ataffanel/fp65/mpu-a/readme.md

# wdc65C02s CPU board with clock

CPU board for the 65C02.

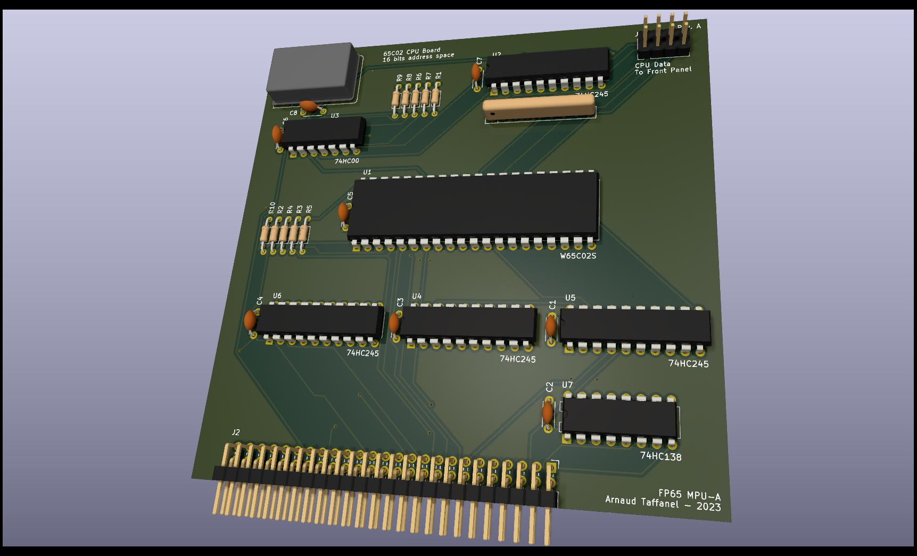
[picture p2: mpu-a/doc/mpu-a.jpg]
Render of the cpu board


Implements support for a crystall oscillator and connector and logic for a front-pannel to access the CPU data line even when isolated from the backplane.

Also generates an enable signal for selecting the IO pages at ```$Cxxx```.
