ataffanel/fp65/(list of files, drawings)

Other design files:
ram-a/freerouting.dsn
