ataffanel/fp65/sio-a/sio-a.kicad_pcb

## KiCad design sio-a/sio-a.kicad_pcb (2023-12-28)

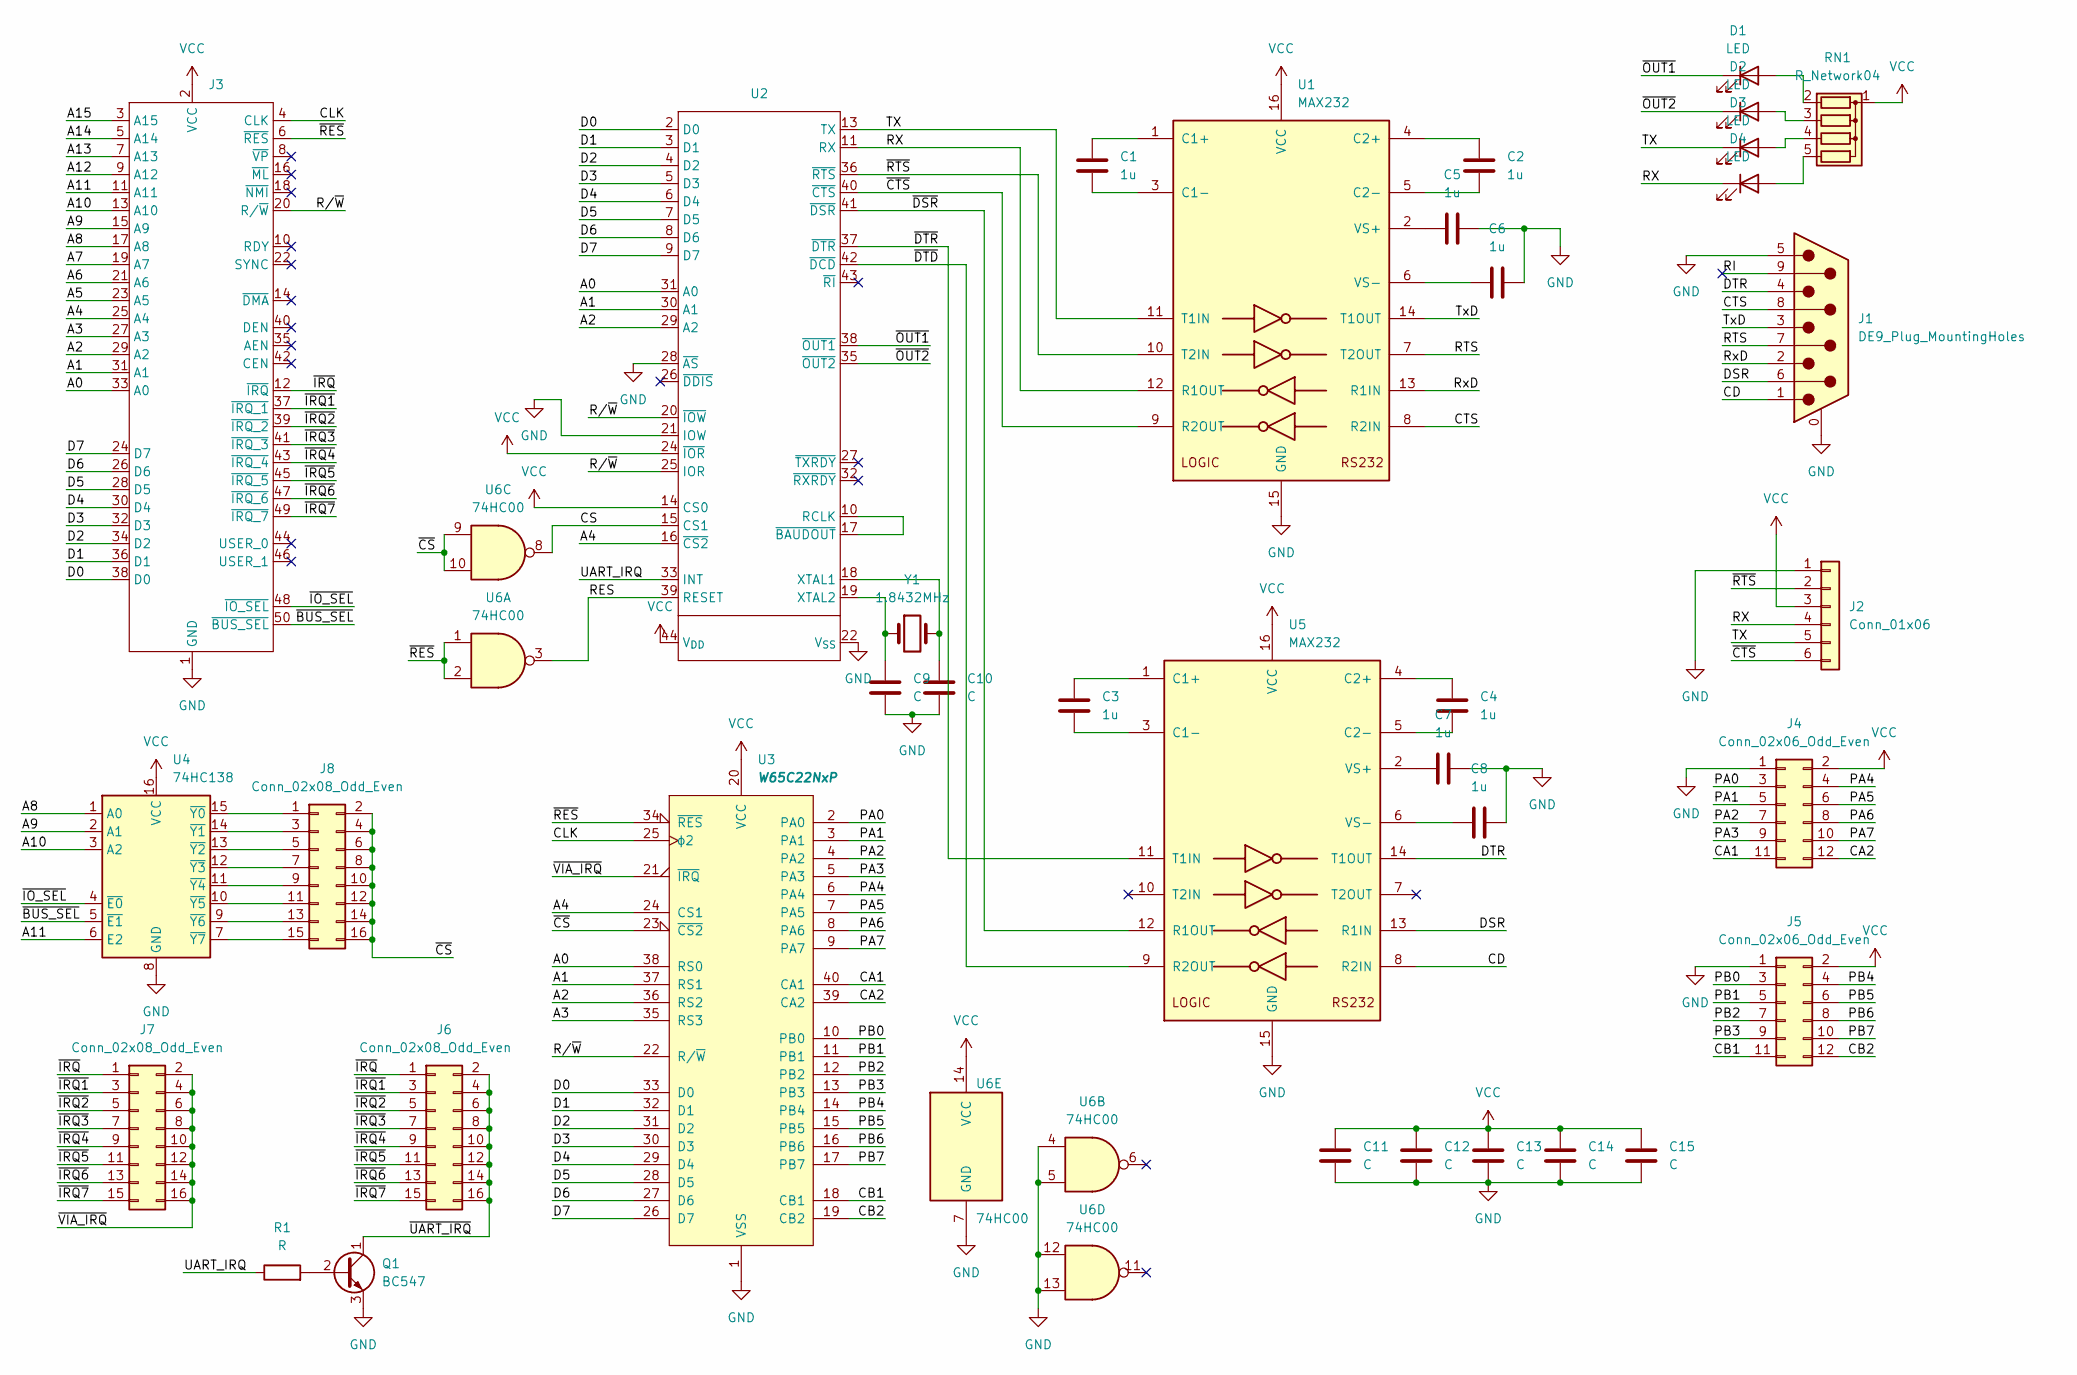
[picture p3: schematic sio-a.kicad_sch]

Parts:
C1, C2, C3, C4, C5, C6, C7, C8: 1u; C_Disc_D5.0mm_W2.5mm_P5.00mm
C9, C10, C11, C12, C13, C14, C15: C; C_Disc_D5.0mm_W2.5mm_P5.00mm
D1, D2, D3, D4: LED; LED_D3.0mm_Horizontal_O1.27mm_Z2.0mm
J1: DE9_Plug_MountingHoles; DSUB-9_Male_Horizontal_P2.77x2.84mm_EdgePinOffset9.90mm_Hou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
J2: Conn_01x06; PinHeader_1x06_P2.54mm_Horizontal
J3: PinHeader_2x25_P2.54mm_Horizontal
J4, J5: Conn_02x06_Odd_Even; PinHeader_2x06_P2.54mm_Vertical
J6, J7, J8: Conn_02x08_Odd_Even; PinHeader_2x08_P2.54mm_Vertical
Q1: BC547; TO-92_Inline
R1: R; R_Axial_DIN0207_L6.3mm_D2.5mm_P10.16mm_Horizontal
RN1: R_Network04; R_Array_SIP5
U1, U5: MAX232; DIP-16_W7.62mm
U2: PLCC-44_THT-Socket
U3: W65C22NxP; DIP-40_W15.24mm
U4: 74HC138; DIP-16_W7.62mm
U6: 74HC00; DIP-14_W7.62mm
Y1: 1.8432MHz; Crystal_HC49-U_Vertical

Connections:
/A0: J3.33 (A0), U2.31 (A0), U3.38 (RS0)
/A1: J3.31 (A1), U2.30 (A1), U3.37 (RS1)
/A2: J3.29 (A2), U2.29 (A2), U3.36 (RS2)
/A3: J3.27 (A3), U3.35 (RS3)
/A4: J3.25 (A4), U2.16 (~CS2), U3.24 (CS1)
/A5: J3.23 (A5)
/A6: J3.21 (A6)
/A7: J3.19 (A7)
/A8: J3.17 (A8), U4.1 (A0)
/A9: J3.15 (A9), U4.2 (A1)
/A10: J3.13 (A10), U4.3 (A2)
/A11: J3.11 (A11), U4.6 (E2)
/A12: J3.9 (A12)
/A13: J3.7 (A13)
/A14: J3.5 (A14)
/A15: J3.3 (A15)
/CA1: J4.11, U3.40 (CA1)
/CA2: J4.12, U3.39 (CA2)
/CB1: J5.11, U3.18 (CB1)
/CB2: J5.12, U3.19 (CB2)
/CD: J1.1, U5.8 (R2IN)
/CLK: J3.4 (CLK), U3.25 (ϕ2)
/CS: U2.15 (CS1), U6.8
/CTS: J1.8, U1.8 (R2IN)
/D0: J3.38 (D0), U2.2 (D0), U3.33 (D0)
/D1: J3.36 (D1), U2.3 (D1), U3.32 (D1)
/D2: J3.34 (D2), U2.4 (D2), U3.31 (D2)
/D3: J3.32 (D3), U2.5 (D3), U3.30 (D3)
/D4: J3.30 (D4), U2.6 (D4), U3.29 (D4)
/D5: J3.28 (D5), U2.7 (D5), U3.28 (D5)
/D6: J3.26 (D6), U2.8 (D6), U3.27 (D6)
/D7: J3.24 (D7), U2.9 (D7), U3.26 (D7)
/DSR: J1.6, U5.13 (R1IN)
/DTR: J1.4, U5.14 (T1OUT)
/PA0: J4.3, U3.2 (PA0)
/PA1: J4.5, U3.3 (PA1)
/PA2: J4.7, U3.4 (PA2)
/PA3: J4.9, U3.5 (PA3)
/PA4: J4.4, U3.6 (PA4)
/PA5: J4.6, U3.7 (PA5)
/PA6: J4.8, U3.8 (PA6)
/PA7: J4.10, U3.9 (PA7)
/PB0: J5.3, U3.10 (PB0)
/PB1: J5.5, U3.11 (PB1)
/PB2: J5.7, U3.12 (PB2)
/PB3: J5.9, U3.13 (PB3)
/PB4: J5.4, U3.14 (PB4)
/PB5: J5.6, U3.15 (PB5)
/PB6: J5.8, U3.16 (PB6)
/PB7: J5.10, U3.17 (PB7)
/RES: U2.39 (RESET), U6.3
/RI: J1.9
/RTS: J1.7, U1.7 (T2OUT)
/RX: D4.1 (K), J2.4, U1.12 (R1OUT), U2.11 (RX)
/RxD: J1.2, U1.13 (R1IN)
/R/~W: J3.20 (R/~W), U2.20 (~IOW), U2.25 (IOR), U3.22 (R/~W)
/TX: D3.1 (K), J2.5, U1.11 (T1IN), U2.13 (TX)
/TxD: J1.3, U1.14 (T1OUT)
/UART_IRQ: R1.1, U2.33 (INT)
/~BUS_SEL: J3.50 (~BUS_SEL), U4.5 (~E1)
/~CS: J8.2, J8.4, J8.6, J8.8, J8.10, J8.12, J8.14, J8.16, U3.23 (~CS2), U6.9, U6.10
/~CTS: J2.6, U1.9 (R2OUT), U2.40 (~CTS)
/~DSR: U2.41 (~DSR), U5.12 (R1OUT)
/~DTD: U2.42 (~DCD), U5.9 (R2OUT)
/~DTR: U2.37 (~DTR), U5.11 (T1IN)
/~IO_SEL: J3.48 (~IO_SEL), U4.4 (~E0)
/~IRQ1: J3.37 (~IRQ_1), J6.3, J7.3
/~IRQ2: J3.39 (~IRQ_2), J6.5, J7.5
/~IRQ3: J3.41 (~IRQ_3), J6.7, J7.7
/~IRQ4: J3.43 (~IRQ_4), J6.9, J7.9
/~IRQ5: J3.45 (~IRQ_5), J6.11, J7.11
/~IRQ6: J3.47 (~IRQ_6), J6.13, J7.13
/~IRQ7: J3.49 (~IRQ_7), J6.15, J7.15
/~IRQ: J3.12 (~IRQ), J6.1, J7.1
/~OUT1: D1.1 (K), U2.38 (~OUT1)
/~OUT2: D2.1 (K), U2.35 (~OUT2)
/~RES: J3.6 (~RES), U3.34 (~RES), U6.1, U6.2
/~RTS: J2.2, U1.10 (T2IN), U2.36 (~RTS)
/~UART_IRQ: J6.2, J6.4, J6.6, J6.8, J6.10, J6.12, J6.14, J6.16, Q1.1 (C)
/~VIA_IRQ: J7.2, J7.4, J7.6, J7.8, J7.10, J7.12, J7.14, J7.16, U3.21 (~IRQ)
GND: C5.2, C6.2, C7.1, C8.2, C9.2, C10.2, C11.2, C12.2, C13.2, C14.2, C15.2, J1.0 (PAD), J1.5, J2.1, J3.1 (GND), J4.1, J5.1, Q1.3 (E), U1.15 (GND), U2.21 (IOW), U2.22 (V_{SS}), U2.28 (~AS), U3.1 (VSS), U4.8 (GND), U5.15 (GND), U6.4, U6.5, U6.7 (GND), U6.12, U6.13
unnamed: D1.2 (A), RN1.2 (R1)
unnamed: D2.2 (A), RN1.3 (R2)
unnamed: D3.2 (A), RN1.4 (R3)
unnamed: D4.2 (A), RN1.5 (R4)
unnamed: J8.1, U4.15 (~Y0)
unnamed: J8.3, U4.14 (~Y1)
unnamed: J8.5, U4.13 (~Y2)
unnamed: J8.7, U4.12 (~Y3)
unnamed: J8.9, U4.11 (~Y4)
unnamed: J8.11, U4.10 (~Y5)
unnamed: J8.13, U4.9 (~Y6)
unnamed: J8.15, U4.7 (~Y7)
unnamed: Q1.2 (B), R1.2
unnamed: C1.1, U1.1 (C1+)
unnamed: C1.2, U1.3 (C1-)
unnamed: C2.1, U1.4 (C2+)
unnamed: C2.2, U1.5 (C2-)
unnamed: C5.1, U1.2 (VS+)
unnamed: C6.1, U1.6 (VS-)
unnamed: U2.10 (RCLK), U2.17 (~BAUDOUT)
unnamed: C10.1, U2.18 (XTAL1), Y1.2
unnamed: C9.1, U2.19 (XTAL2), Y1.1
unnamed: C3.1, U5.1 (C1+)
unnamed: C3.2, U5.3 (C1-)
unnamed: C4.1, U5.4 (C2+)
unnamed: C4.2, U5.5 (C2-)
unnamed: C7.2, U5.2 (VS+)
unnamed: C8.1, U5.6 (VS-)
VCC: C11.1, C12.1, C13.1, C14.1, C15.1, J2.3, J3.2 (VCC), J4.2, J5.2, RN1.1 (common), U1.16 (VCC), U2.14 (CS0), U2.24 (~IOR), U2.44 (V_{DD}), U3.20 (VCC), U4.16 (VCC), U5.16 (VCC), U6.14 (VCC)

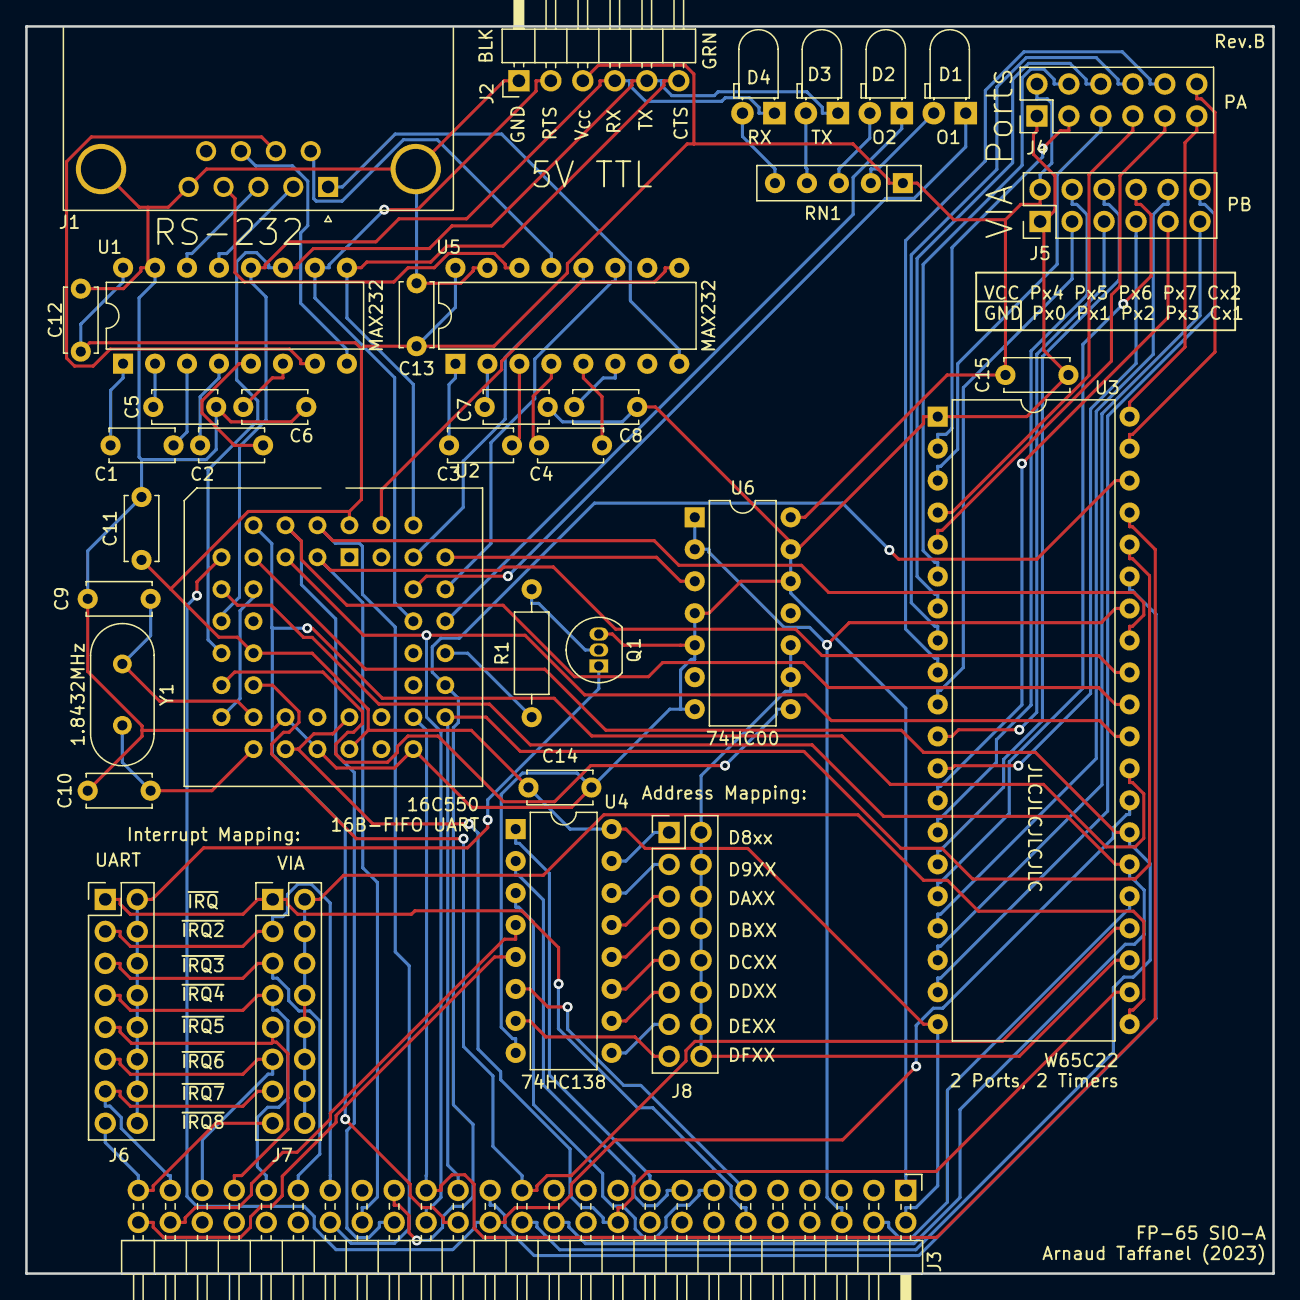
[picture p4: board sio-a.kicad_pcb from above]

Board: 2 copper layers, 99.1 x 99.1 mm, 37 parts (0 on the bottom side), 102 nets.
