ataffanel/fp65/scsi-a/scsi-a.kicad_pcb

## KiCad design scsi-a/scsi-a.kicad_pcb (2023-12-28)

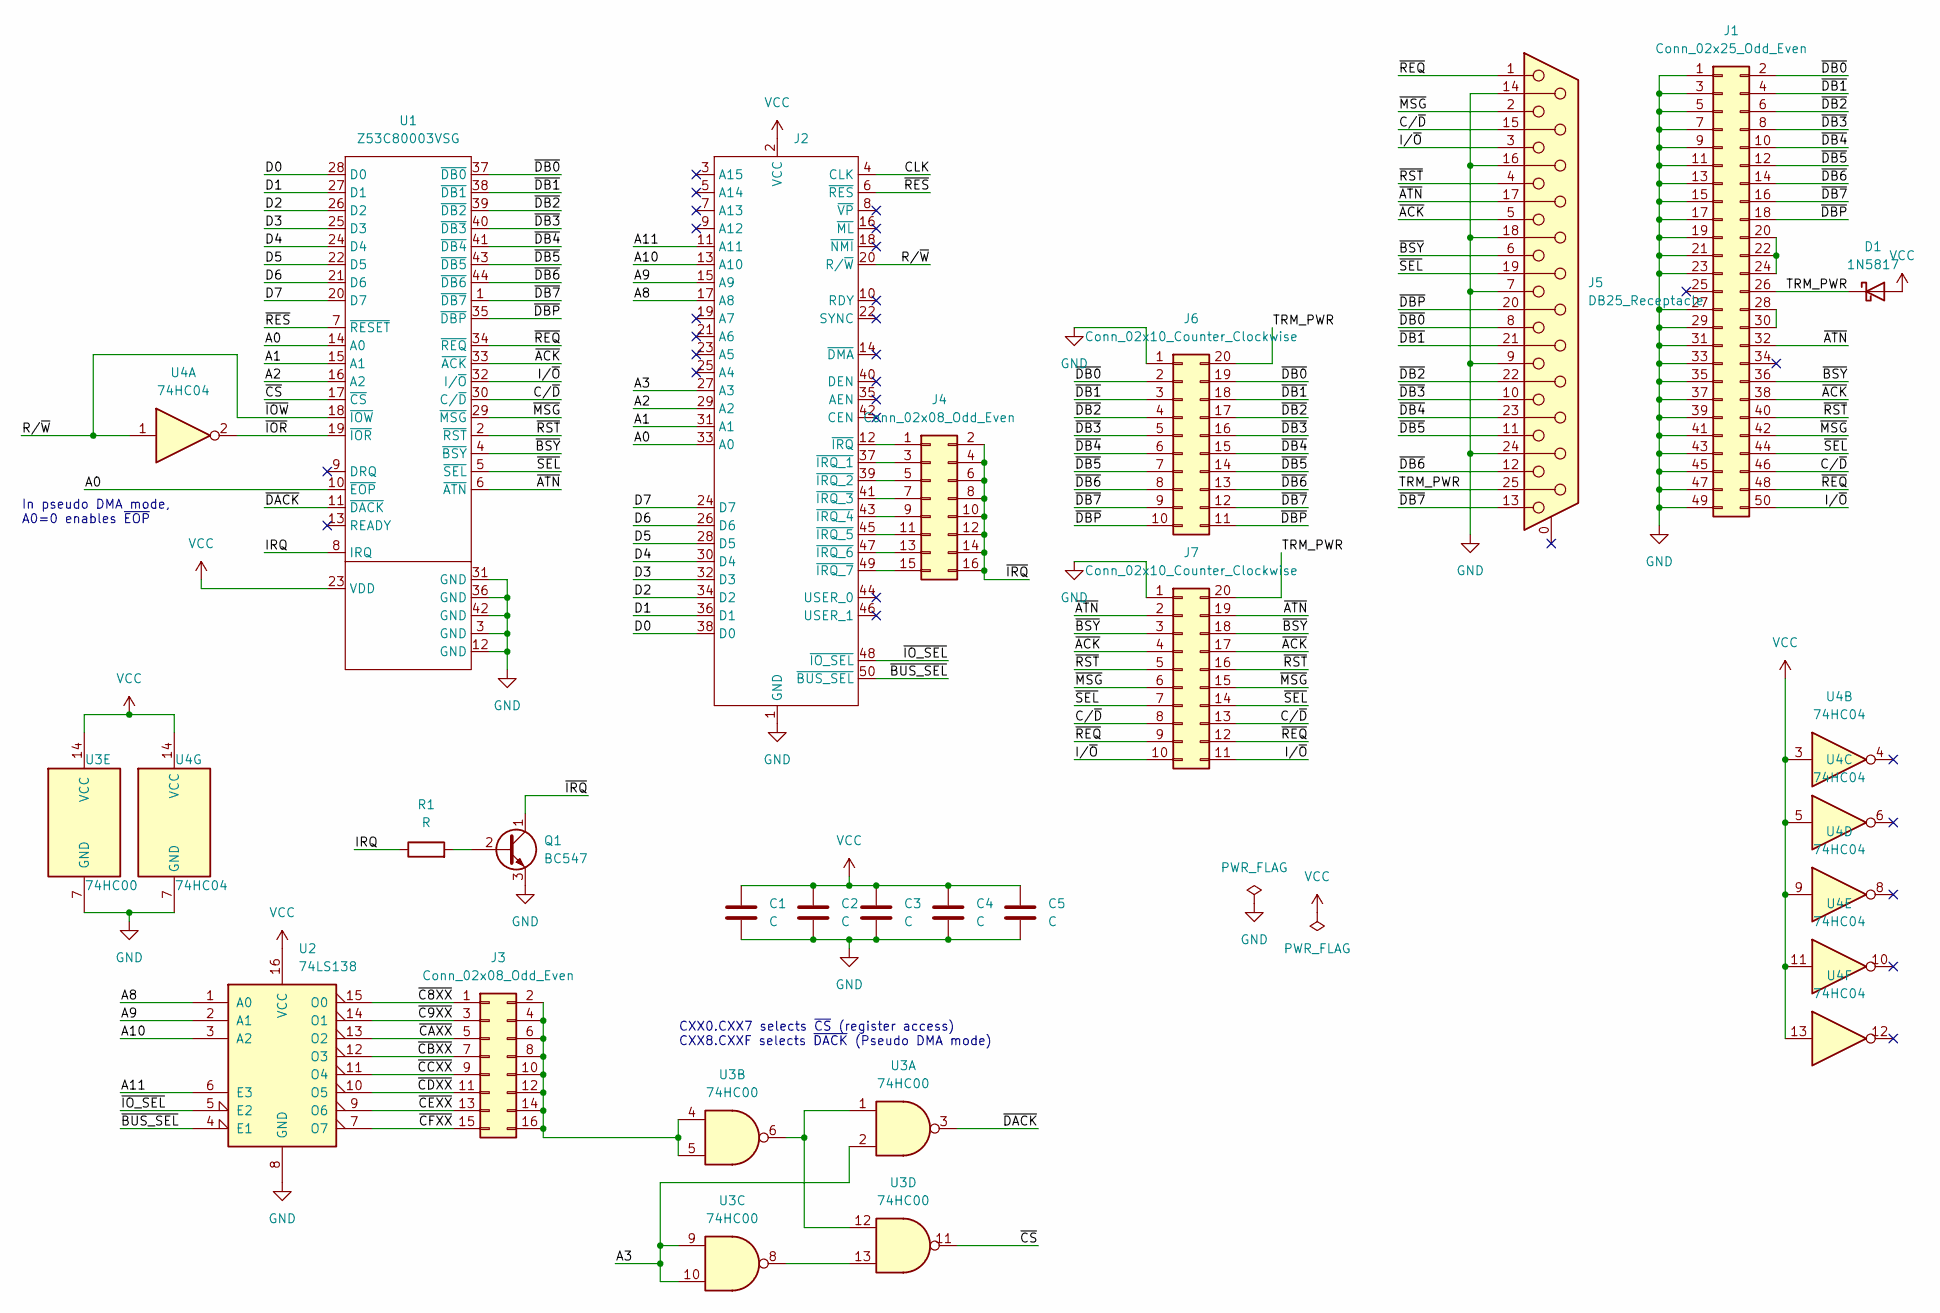
[picture p5: schematic scsi-a.kicad_sch, FP65 SCSI-SC interface]

Parts:
C1, C2, C3, C5: C; C_Disc_D5.0mm_W2.5mm_P5.00mm
C4: C; CP_Radial_D5.0mm_P2.00mm
D1: 1N5817; D_DO-41_SOD81_P10.16mm_Horizontal
J1: Conn_02x25_Odd_Even; IDC-Header_2x25_P2.54mm_Horizontal
J2: PinHeader_2x25_P2.54mm_Horizontal
J3, J4: Conn_02x08_Odd_Even; PinHeader_2x08_P2.54mm_Vertical
J5: DB25_Receptacle; DSUB-25_Female_Horizontal_P2.77x2.84mm_EdgePinOffset9.90mm_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
J6, J7: Conn_02x10_Counter_Clockwise; DIP-20_W7.62mm_Socket
Q1: BC547; TO-92_Inline
R1: R; R_Axial_DIN0204_L3.6mm_D1.6mm_P7.62mm_Horizontal
U1: Z53C80003VSG; PLCC-44_THT-Socket
U2: 74LS138; DIP-16_W7.62mm
U3: 74HC00; DIP-14_W7.62mm
U4: 74HC04; DIP-14_W7.62mm

Connections:
/A0: J2.33 (A0), U1.10 (~EOP), U1.14 (A0)
/A1: J2.31 (A1), U1.15 (A1)
/A2: J2.29 (A2), U1.16 (A2)
/A3: J2.27 (A3), U3.2, U3.9, U3.10
/A8: J2.17 (A8), U2.1 (A0)
/A9: J2.15 (A9), U2.2 (A1)
/A10: J2.13 (A10), U2.3 (A2)
/A11: J2.11 (A11), U2.6 (E3)
/CLK: J2.4 (CLK)
/C/~D: J1.46, J5.15, J7.8, J7.13, U1.30 (C/~D)
/D0: J2.38 (D0), U1.28 (D0)
/D1: J2.36 (D1), U1.27 (D1)
/D2: J2.34 (D2), U1.26 (D2)
/D3: J2.32 (D3), U1.25 (D3)
/D4: J2.30 (D4), U1.24 (D4)
/D5: J2.28 (D5), U1.22 (D5)
/D6: J2.26 (D6), U1.21 (D6)
/D7: J2.24 (D7), U1.20 (D7)
/IRQ: R1.1, U1.8 (IRQ)
/I/~O: J1.50, J5.3, J7.10, J7.11, U1.32 (I/~O)
/R/~W: J2.20 (R/~W), U1.18 (~IOW), U4.1
/TRM_PWR: D1.1 (K), J1.26, J5.25, J6.20, J7.20
/~ACK: J1.38, J5.5, J7.4, J7.17, U1.33 (~ACK)
/~ATN: J1.32, J5.17, J7.2, J7.19, U1.6 (~ATN)
/~BSY: J1.36, J5.6, J7.3, J7.18, U1.4 (~BSY)
/~BUS_SEL: J2.50 (~BUS_SEL), U2.4 (E1)
/~C8XX: J3.1, U2.15 (O0)
/~C9XX: J3.3, U2.14 (O1)
/~CAXX: J3.5, U2.13 (O2)
/~CBXX: J3.7, U2.12 (O3)
/~CCXX: J3.9, U2.11 (O4)
/~CDXX: J3.11, U2.10 (O5)
/~CEXX: J3.13, U2.9 (O6)
/~CFXX: J3.15, U2.7 (O7)
/~CS: U1.17 (~CS), U3.11
/~DACK: U1.11 (~DACK), U3.3
/~DB0: J1.2, J5.8, J6.2, J6.19, U1.37 (~DB0)
/~DB1: J1.4, J5.21, J6.3, J6.18, U1.38 (~DB1)
/~DB2: J1.6, J5.22, J6.4, J6.17, U1.39 (~DB2)
/~DB3: J1.8, J5.10, J6.5, J6.16, U1.40 (~DB3)
/~DB4: J1.10, J5.23, J6.6, J6.15, U1.41 (~DB4)
/~DB5: J1.12, J5.11, J6.7, J6.14, U1.43 (~DB5)
/~DB6: J1.14, J5.12, J6.8, J6.13, U1.44 (~DB6)
/~DB7: J1.16, J5.13, J6.9, J6.12, U1.1 (~DB7)
/~DBP: J1.18, J5.20, J6.10, J6.11, U1.35 (~DBP)
/~IOR: U1.19 (~IOR), U4.2
/~IO_SEL: J2.48 (~IO_SEL), U2.5 (E2)
/~IRQ: J4.2, J4.4, J4.6, J4.8, J4.10, J4.12, J4.14, J4.16, Q1.1 (C)
/~MSG: J1.42, J5.2, J7.6, J7.15, U1.29 (~MSG)
/~REQ: J1.48, J5.1, J7.9, J7.12, U1.34 (~REQ)
/~RES: J2.6 (~RES), U1.7 (~RESET)
/~RST: J1.40, J5.4, J7.5, J7.16, U1.2 (~RST)
/~SEL: J1.44, J5.19, J7.7, J7.14, U1.5 (~SEL)
GND: C1.2, C2.2, C3.2, C4.2, C5.2, J1.1, J1.3, J1.5, J1.7, J1.9, J1.11, J1.13, J1.15, J1.17, J1.19, J1.21, J1.23, J1.27, J1.29, J1.31, J1.33, J1.35, J1.37, J1.39, J1.41, J1.43, J1.45, J1.47, J1.49, J2.1 (GND), J5.7, J5.9, J5.14, J5.16, J5.18, J5.24, J6.1, J7.1, Q1.3 (E), U1.3 (GND), U1.12 (GND), U1.31 (GND), U1.36 (GND), U1.42 (GND), U2.8 (GND), U3.7 (GND), U4.7 (GND)
unnamed: J1.20, J1.22, J1.24
unnamed: J1.28, J1.30
unnamed: J2.37 (~IRQ_1), J4.3
unnamed: J2.39 (~IRQ_2), J4.5
unnamed: J2.41 (~IRQ_3), J4.7
unnamed: J2.43 (~IRQ_4), J4.9
unnamed: J2.45 (~IRQ_5), J4.11
unnamed: J2.47 (~IRQ_6), J4.13
unnamed: J2.49 (~IRQ_7), J4.15
unnamed: J2.12 (~IRQ), J4.1
unnamed: J3.2, J3.4, J3.6, J3.8, J3.10, J3.12, J3.14, J3.16, U3.4, U3.5
unnamed: Q1.2 (B), R1.2
unnamed: U3.1, U3.6, U3.12
unnamed: U3.8, U3.13
VCC: C1.1, C2.1, C3.1, C4.1, C5.1, D1.2 (A), J2.2 (VCC), U1.23 (VDD), U2.16 (VCC), U3.14 (VCC), U4.3, U4.5, U4.9, U4.11, U4.13, U4.14 (VCC)

Notes on the sheet:
CXX0.CXX7 selects ~{CS} (register access) CXX8.CXXF selects ~{DACK} (Pseudo DMA mode)
In pseudo DMA mode, A0=0 enables ~{EOP}

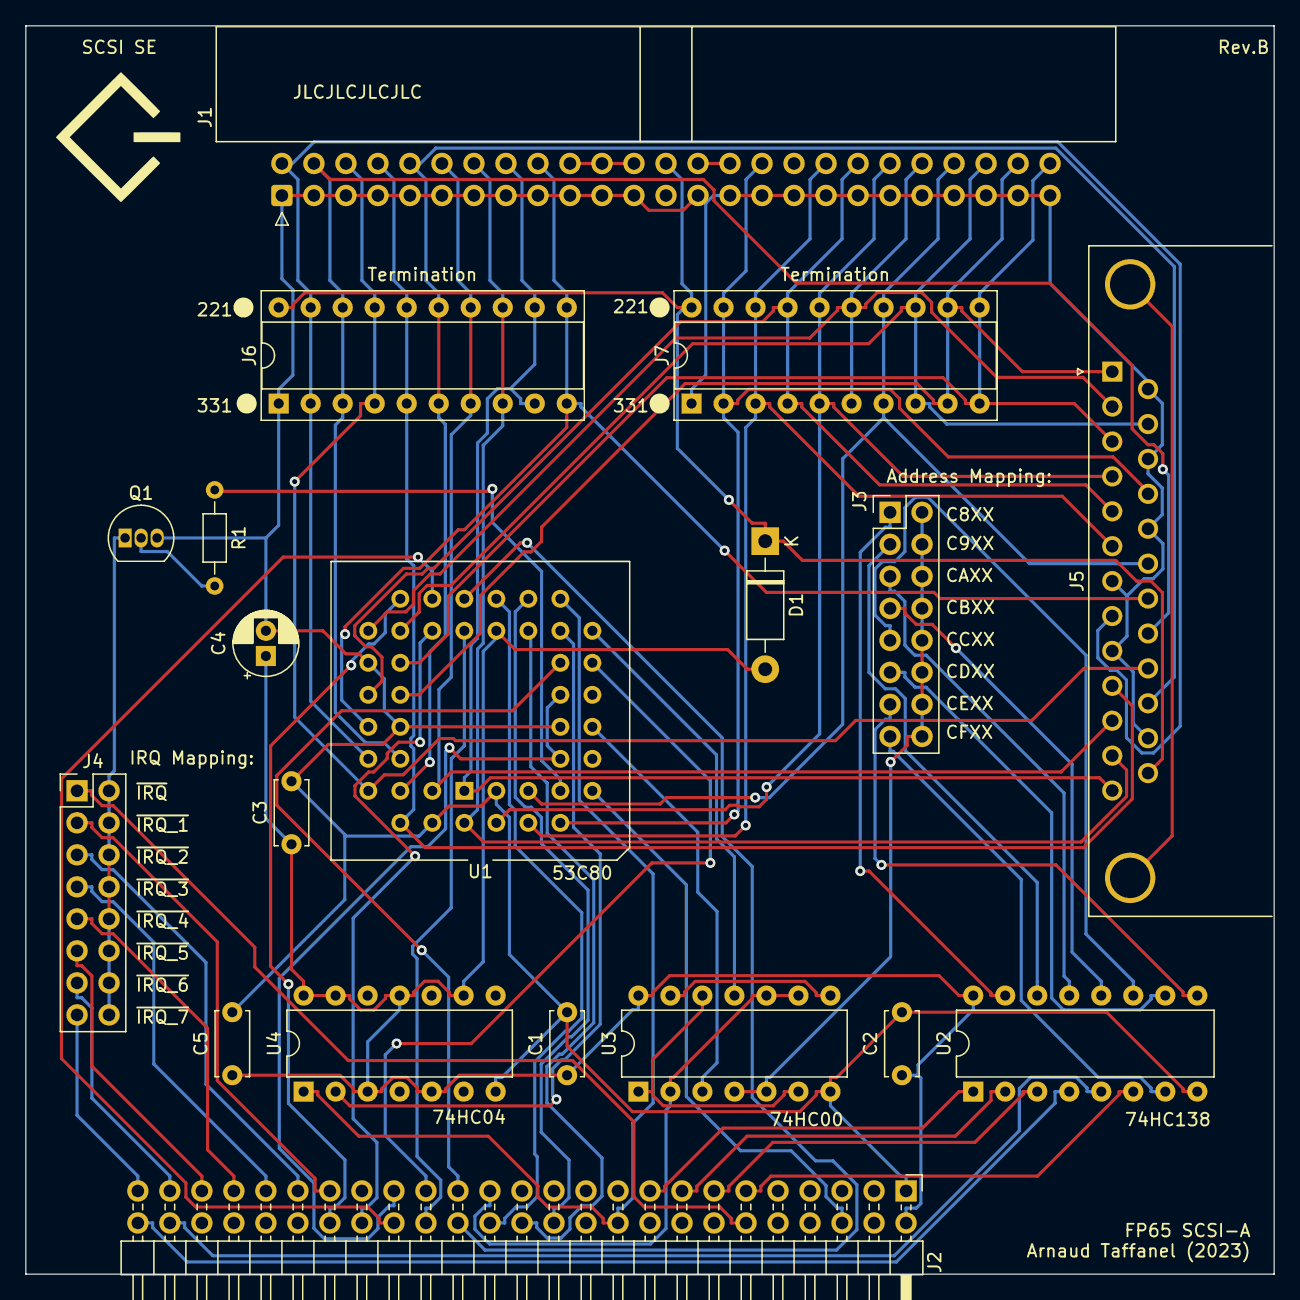
[picture p6: board scsi-a.kicad_pcb from above]

Board: 2 copper layers, 99.1 x 99.1 mm, 19 parts (0 on the bottom side), 68 nets.
