ataffanel/fp65/mpu-a/mpu-a.kicad_pcb

## KiCad design mpu-a/mpu-a.kicad_pcb (2023-12-28)

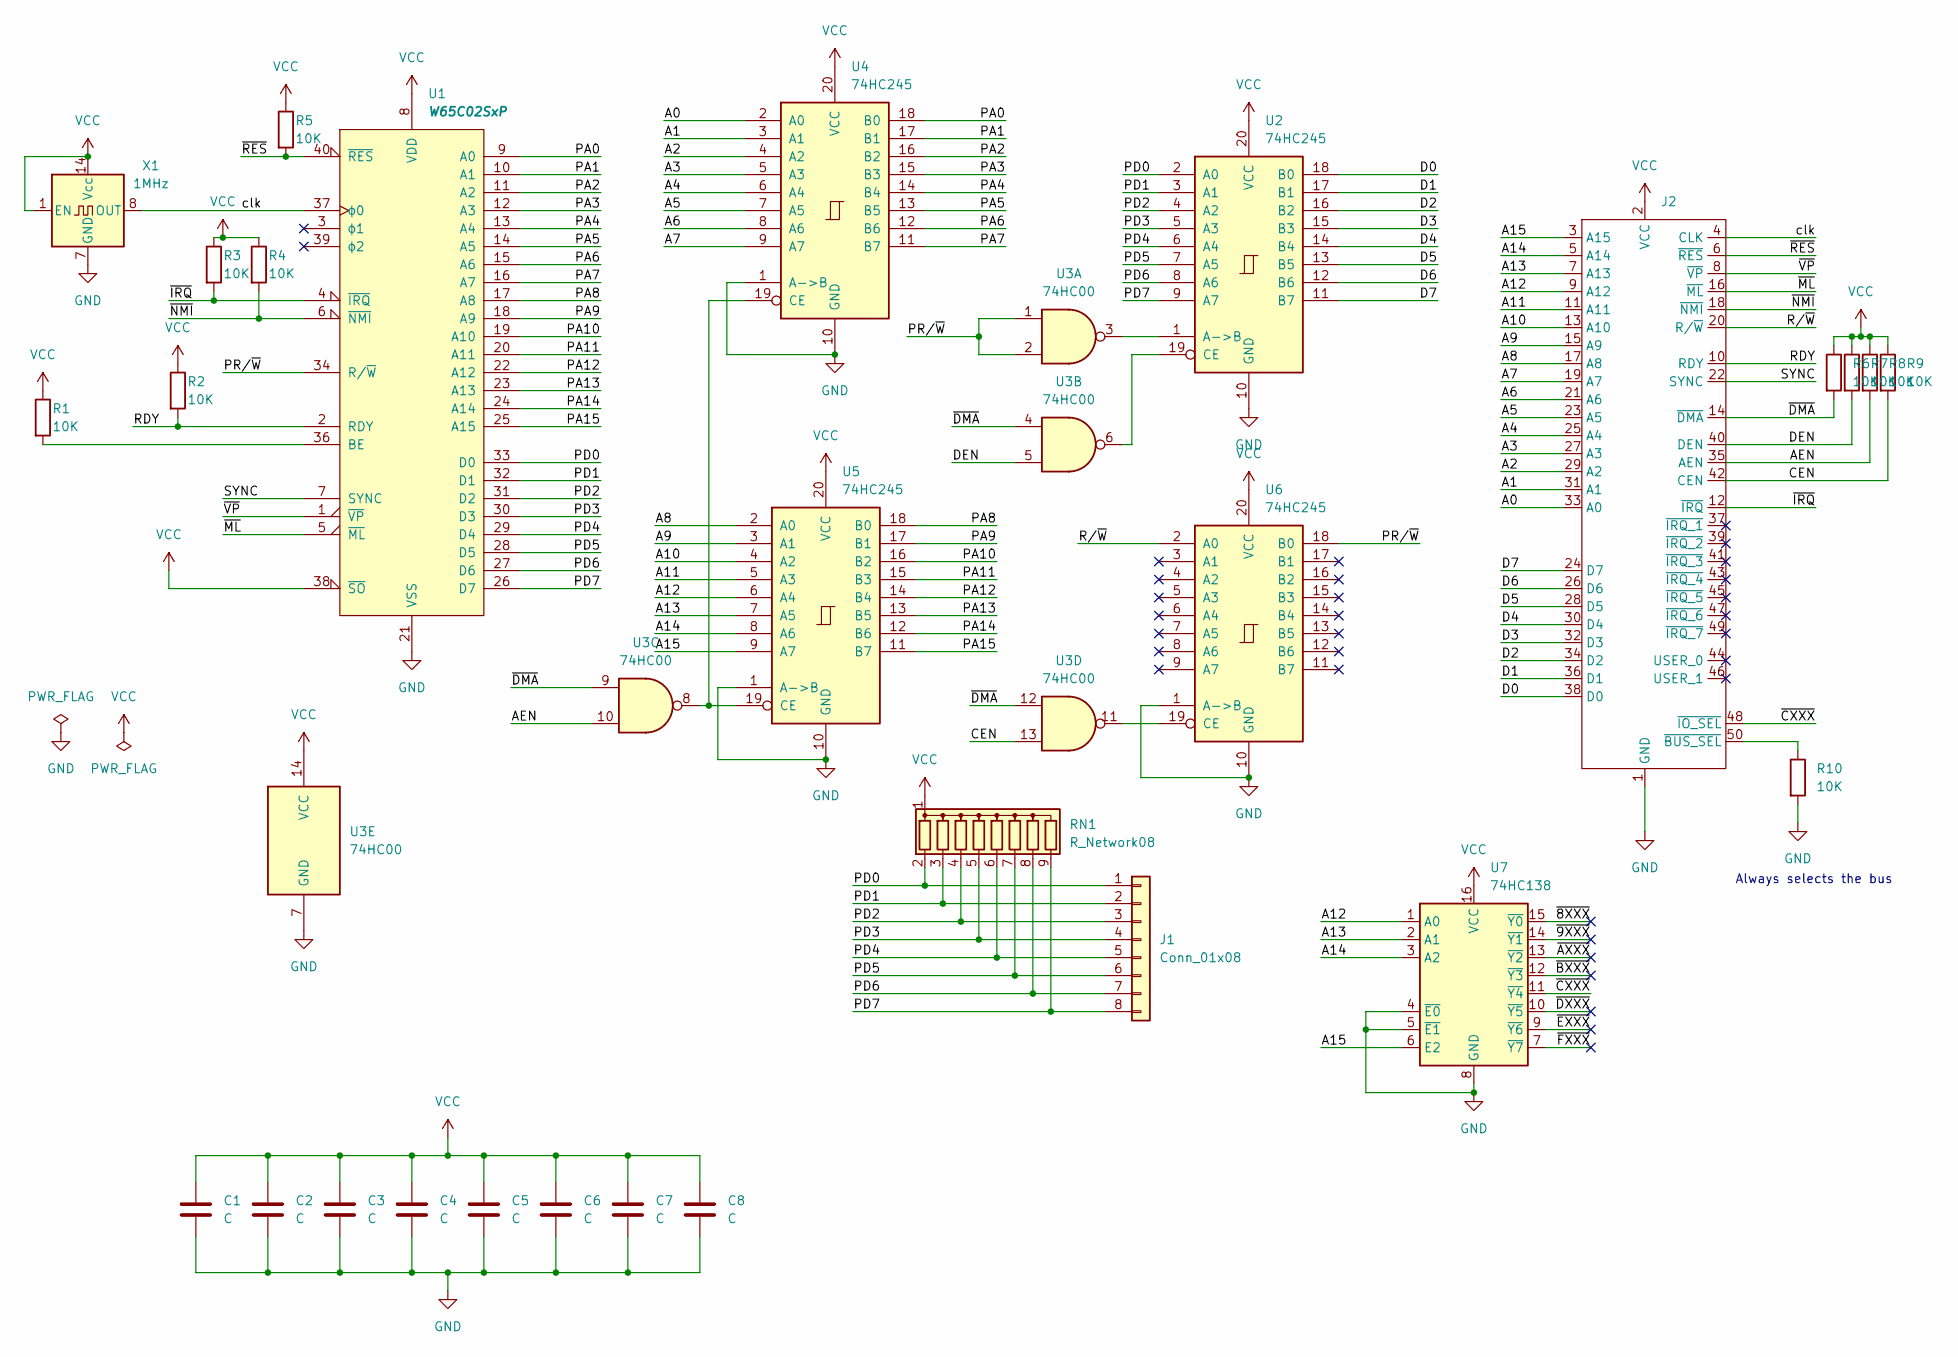
[picture p7: schematic mpu-a.kicad_sch]

Parts:
C1, C2, C3, C4, C5, C6, C7, C8: C; C_Disc_D4.3mm_W1.9mm_P5.00mm
J1: Conn_01x08; PinHeader_2x04_P2.54mm_Vertical
J2: PinHeader_2x25_P2.54mm_Horizontal
R1, R2, R3, R4, R5, R6, R7, R8, R9, R10: 10K; R_Axial_DIN0204_L3.6mm_D1.6mm_P7.62mm_Horizontal
RN1: R_Network08; R_Array_SIP9
U1: W65C02SxP; DIP-40_W15.24mm
U2, U4, U5, U6: 74HC245; DIP-20_W7.62mm
U3: 74HC00; DIP-14_W7.62mm
U7: 74HC138; DIP-16_W7.62mm
X1: 1MHz; Oscillator_DIP-14

Connections:
/A0: J2.33 (A0), U4.2 (A0)
/A1: J2.31 (A1), U4.3 (A1)
/A2: J2.29 (A2), U4.4 (A2)
/A3: J2.27 (A3), U4.5 (A3)
/A4: J2.25 (A4), U4.6 (A4)
/A5: J2.23 (A5), U4.7 (A5)
/A6: J2.21 (A6), U4.8 (A6)
/A7: J2.19 (A7), U4.9 (A7)
/A8: J2.17 (A8), U5.2 (A0)
/A9: J2.15 (A9), U5.3 (A1)
/A10: J2.13 (A10), U5.4 (A2)
/A11: J2.11 (A11), U5.5 (A3)
/A12: J2.9 (A12), U5.6 (A4), U7.1 (A0)
/A13: J2.7 (A13), U5.7 (A5), U7.2 (A1)
/A14: J2.5 (A14), U5.8 (A6), U7.3 (A2)
/A15: J2.3 (A15), U5.9 (A7), U7.6 (E2)
/AEN: J2.35 (AEN), R8.2, U3.10
/CEN: J2.42 (CEN), R9.2, U3.13
/D0: J2.38 (D0), U2.18 (B0)
/D1: J2.36 (D1), U2.17 (B1)
/D2: J2.34 (D2), U2.16 (B2)
/D3: J2.32 (D3), U2.15 (B3)
/D4: J2.30 (D4), U2.14 (B4)
/D5: J2.28 (D5), U2.13 (B5)
/D6: J2.26 (D6), U2.12 (B6)
/D7: J2.24 (D7), U2.11 (B7)
/DEN: J2.40 (DEN), R7.2, U3.5
/PA0: U1.9 (A0), U4.18 (B0)
/PA1: U1.10 (A1), U4.17 (B1)
/PA2: U1.11 (A2), U4.16 (B2)
/PA3: U1.12 (A3), U4.15 (B3)
/PA4: U1.13 (A4), U4.14 (B4)
/PA5: U1.14 (A5), U4.13 (B5)
/PA6: U1.15 (A6), U4.12 (B6)
/PA7: U1.16 (A7), U4.11 (B7)
/PA8: U1.17 (A8), U5.18 (B0)
/PA9: U1.18 (A9), U5.17 (B1)
/PA10: U1.19 (A10), U5.16 (B2)
/PA11: U1.20 (A11), U5.15 (B3)
/PA12: U1.22 (A12), U5.14 (B4)
/PA13: U1.23 (A13), U5.13 (B5)
/PA14: U1.24 (A14), U5.12 (B6)
/PA15: U1.25 (A15), U5.11 (B7)
/PD0: J1.1, RN1.2 (R1), U1.33 (D0), U2.2 (A0)
/PD1: J1.2, RN1.3 (R2), U1.32 (D1), U2.3 (A1)
/PD2: J1.3, RN1.4 (R3), U1.31 (D2), U2.4 (A2)
/PD3: J1.4, RN1.5 (R4), U1.30 (D3), U2.5 (A3)
/PD4: J1.5, RN1.6 (R5), U1.29 (D4), U2.6 (A4)
/PD5: J1.6, RN1.7 (R6), U1.28 (D5), U2.7 (A5)
/PD6: J1.7, RN1.8 (R7), U1.27 (D6), U2.8 (A6)
/PD7: J1.8, RN1.9 (R8), U1.26 (D7), U2.9 (A7)
/PR/~W: U1.34 (R/~W), U3.1, U3.2, U6.18 (B0)
/RDY: J2.10 (RDY), R2.2, U1.2 (RDY)
/R/~W: J2.20 (R/~W), U6.2 (A0)
/SYNC: J2.22 (SYNC), U1.7 (SYNC)
/clk: J2.4 (CLK), U1.37 (ϕ0), X1.8 (OUT)
/~8XXX: U7.15 (~Y0)
/~9XXX: U7.14 (~Y1)
/~AXXX: U7.13 (~Y2)
/~BXXX: U7.12 (~Y3)
/~CXXX: J2.48 (~IO_SEL), U7.11 (~Y4)
/~DMA: J2.14 (~DMA), R6.2, U3.4, U3.9, U3.12
/~DXXX: U7.10 (~Y5)
/~EXXX: U7.9 (~Y6)
/~FXXX: U7.7 (~Y7)
/~IRQ: J2.12 (~IRQ), R3.2, U1.4 (~IRQ)
/~ML: J2.16 (~ML), U1.5 (~ML)
/~NMI: J2.18 (~NMI), R4.2, U1.6 (~NMI)
/~RES: J2.6 (~RES), R5.2, U1.40 (~RES)
/~VP: J2.8 (~VP), U1.1 (~VP)
GND: C1.2, C2.2, C3.2, C4.2, C5.2, C6.2, C7.2, C8.2, J2.1 (GND), R10.2, U1.21 (VSS), U2.10 (GND), U3.7 (GND), U4.1 (A->B), U4.10 (GND), U5.1 (A->B), U5.10 (GND), U6.1 (A->B), U6.10 (GND), U7.4 (~E0), U7.5 (~E1), U7.8 (GND), X1.7 (GND)
unnamed: J2.50 (~BUS_SEL), R10.1
unnamed: R1.2, U1.36 (BE)
unnamed: U2.1 (A->B), U3.3
unnamed: U2.19 (CE), U3.6
unnamed: U3.8, U4.19 (CE), U5.19 (CE)
unnamed: U3.11, U6.19 (CE)
VCC: C1.1, C2.1, C3.1, C4.1, C5.1, C6.1, C7.1, C8.1, J2.2 (VCC), R1.1, R2.1, R3.1, R4.1, R5.1, R6.1, R7.1, R8.1, R9.1, RN1.1 (common), U1.8 (VDD), U1.38 (~SO), U2.20 (VCC), U3.14 (VCC), U4.20 (VCC), U5.20 (VCC), U6.20 (VCC), U7.16 (VCC), X1.1 (EN), X1.14 (Vcc)

Notes on the sheet:
Always selects the bus

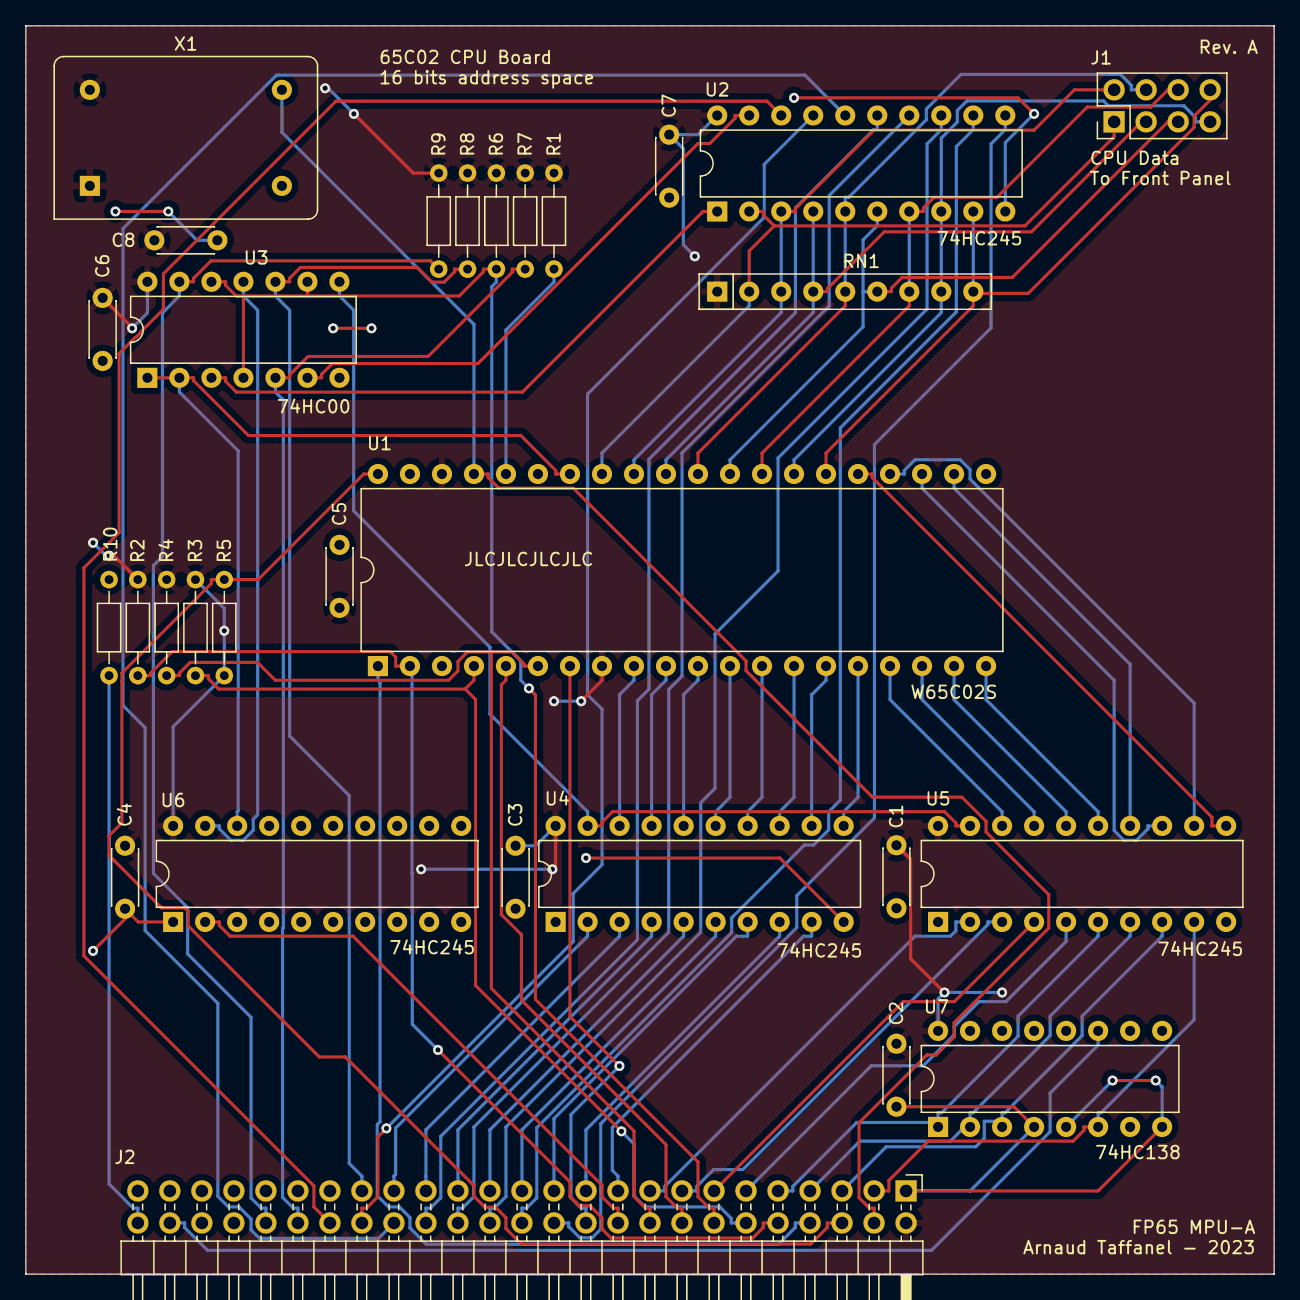
[picture p8: board mpu-a.kicad_pcb from above]

Board: 2 copper layers, 99.1 x 99.1 mm, 29 parts (0 on the bottom side), 71 nets.
