ataffanel/fp65/backplane/backplane.kicad_pcb

## KiCad design backplane/backplane.kicad_pcb (2023-12-28)

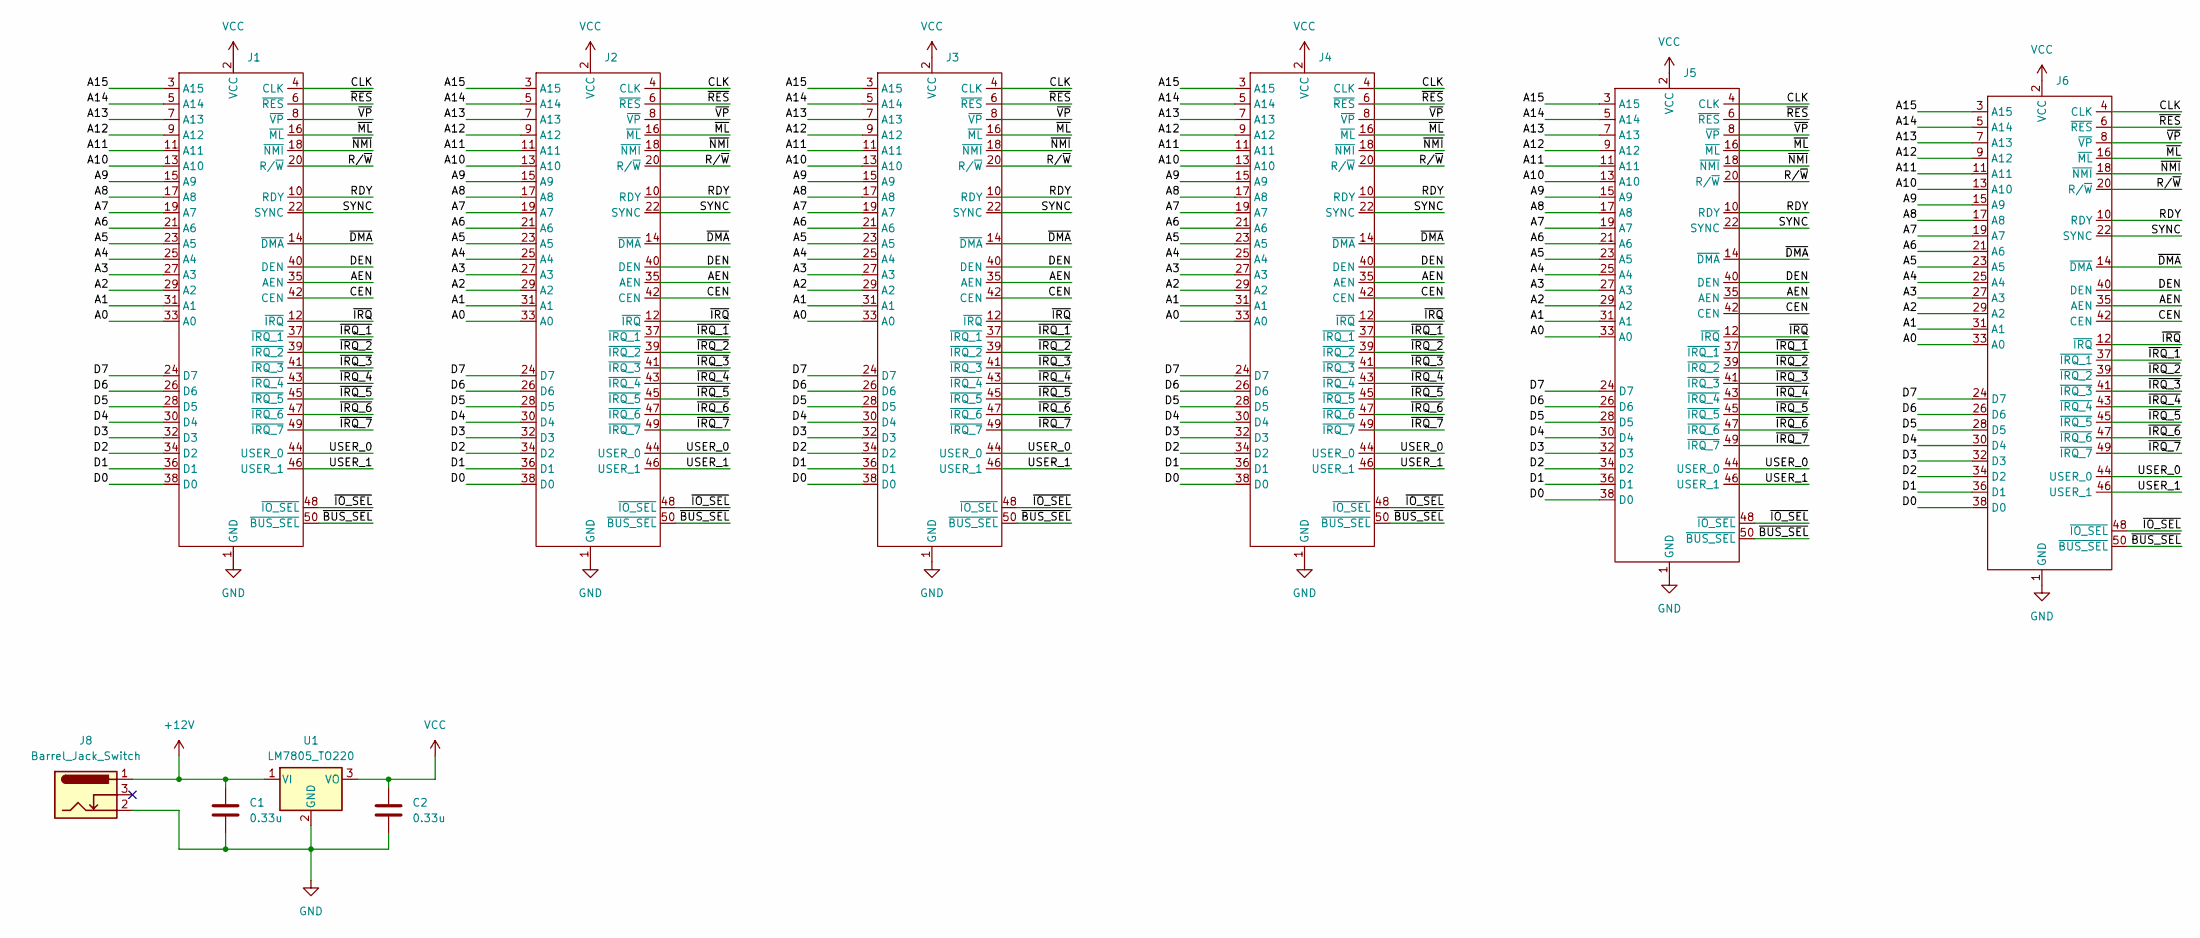
[picture p9: schematic backplane.kicad_sch]

Parts:
C1, C2: 0.33u; C_Disc_D5.0mm_W2.5mm_P5.00mm
J1: PinSocket_2x25_P2.54mm_Horizontal
J2, J3, J4, J5: PinSocket_2x25_P2.54mm_Vertical
J6: PinHeader_2x25_P2.54mm_Horizontal
J8: Barrel_Jack_Switch; BarrelJack_GCT_DCJ200-10-A_Horizontal
U1: LM7805_TO220; TO-220-3_Vertical

Connections:
+12V: C1.1, J8.1, U1.1 (VI)
/A0: J1.33 (A0), J2.33 (A0), J3.33 (A0), J4.33 (A0), J5.33 (A0), J6.33 (A0)
/A1: J1.31 (A1), J2.31 (A1), J3.31 (A1), J4.31 (A1), J5.31 (A1), J6.31 (A1)
/A2: J1.29 (A2), J2.29 (A2), J3.29 (A2), J4.29 (A2), J5.29 (A2), J6.29 (A2)
/A3: J1.27 (A3), J2.27 (A3), J3.27 (A3), J4.27 (A3), J5.27 (A3), J6.27 (A3)
/A4: J1.25 (A4), J2.25 (A4), J3.25 (A4), J4.25 (A4), J5.25 (A4), J6.25 (A4)
/A5: J1.23 (A5), J2.23 (A5), J3.23 (A5), J4.23 (A5), J5.23 (A5), J6.23 (A5)
/A6: J1.21 (A6), J2.21 (A6), J3.21 (A6), J4.21 (A6), J5.21 (A6), J6.21 (A6)
/A7: J1.19 (A7), J2.19 (A7), J3.19 (A7), J4.19 (A7), J5.19 (A7), J6.19 (A7)
/A8: J1.17 (A8), J2.17 (A8), J3.17 (A8), J4.17 (A8), J5.17 (A8), J6.17 (A8)
/A9: J1.15 (A9), J2.15 (A9), J3.15 (A9), J4.15 (A9), J5.15 (A9), J6.15 (A9)
/A10: J1.13 (A10), J2.13 (A10), J3.13 (A10), J4.13 (A10), J5.13 (A10), J6.13 (A10)
/A11: J1.11 (A11), J2.11 (A11), J3.11 (A11), J4.11 (A11), J5.11 (A11), J6.11 (A11)
/A12: J1.9 (A12), J2.9 (A12), J3.9 (A12), J4.9 (A12), J5.9 (A12), J6.9 (A12)
/A13: J1.7 (A13), J2.7 (A13), J3.7 (A13), J4.7 (A13), J5.7 (A13), J6.7 (A13)
/A14: J1.5 (A14), J2.5 (A14), J3.5 (A14), J4.5 (A14), J5.5 (A14), J6.5 (A14)
/A15: J1.3 (A15), J2.3 (A15), J3.3 (A15), J4.3 (A15), J5.3 (A15), J6.3 (A15)
/AEN: J1.35 (AEN), J2.35 (AEN), J3.35 (AEN), J4.35 (AEN), J5.35 (AEN), J6.35 (AEN)
/CEN: J1.42 (CEN), J2.42 (CEN), J3.42 (CEN), J4.42 (CEN), J5.42 (CEN), J6.42 (CEN)
/CLK: J1.4 (CLK), J2.4 (CLK), J3.4 (CLK), J4.4 (CLK), J5.4 (CLK), J6.4 (CLK)
/D0: J1.38 (D0), J2.38 (D0), J3.38 (D0), J4.38 (D0), J5.38 (D0), J6.38 (D0)
/D1: J1.36 (D1), J2.36 (D1), J3.36 (D1), J4.36 (D1), J5.36 (D1), J6.36 (D1)
/D2: J1.34 (D2), J2.34 (D2), J3.34 (D2), J4.34 (D2), J5.34 (D2), J6.34 (D2)
/D3: J1.32 (D3), J2.32 (D3), J3.32 (D3), J4.32 (D3), J5.32 (D3), J6.32 (D3)
/D4: J1.30 (D4), J2.30 (D4), J3.30 (D4), J4.30 (D4), J5.30 (D4), J6.30 (D4)
/D5: J1.28 (D5), J2.28 (D5), J3.28 (D5), J4.28 (D5), J5.28 (D5), J6.28 (D5)
/D6: J1.26 (D6), J2.26 (D6), J3.26 (D6), J4.26 (D6), J5.26 (D6), J6.26 (D6)
/D7: J1.24 (D7), J2.24 (D7), J3.24 (D7), J4.24 (D7), J5.24 (D7), J6.24 (D7)
/DEN: J1.40 (DEN), J2.40 (DEN), J3.40 (DEN), J4.40 (DEN), J5.40 (DEN), J6.40 (DEN)
/RDY: J1.10 (RDY), J2.10 (RDY), J3.10 (RDY), J4.10 (RDY), J5.10 (RDY), J6.10 (RDY)
/R/~W: J1.20 (R/~W), J2.20 (R/~W), J3.20 (R/~W), J4.20 (R/~W), J5.20 (R/~W), J6.20 (R/~W)
/SYNC: J1.22 (SYNC), J2.22 (SYNC), J3.22 (SYNC), J4.22 (SYNC), J5.22 (SYNC), J6.22 (SYNC)
/USER_0: J1.44 (USER_0), J2.44 (USER_0), J3.44 (USER_0), J4.44 (USER_0), J5.44 (USER_0), J6.44 (USER_0)
/USER_1: J1.46 (USER_1), J2.46 (USER_1), J3.46 (USER_1), J4.46 (USER_1), J5.46 (USER_1), J6.46 (USER_1)
/~BUS_SEL: J1.50 (~BUS_SEL), J2.50 (~BUS_SEL), J3.50 (~BUS_SEL), J4.50 (~BUS_SEL), J5.50 (~BUS_SEL), J6.50 (~BUS_SEL)
/~DMA: J1.14 (~DMA), J2.14 (~DMA), J3.14 (~DMA), J4.14 (~DMA), J5.14 (~DMA), J6.14 (~DMA)
/~IO_SEL: J1.48 (~IO_SEL), J2.48 (~IO_SEL), J3.48 (~IO_SEL), J4.48 (~IO_SEL), J5.48 (~IO_SEL), J6.48 (~IO_SEL)
/~IRQ_1: J1.37 (~IRQ_1), J2.37 (~IRQ_1), J3.37 (~IRQ_1), J4.37 (~IRQ_1), J5.37 (~IRQ_1), J6.37 (~IRQ_1)
/~IRQ_2: J1.39 (~IRQ_2), J2.39 (~IRQ_2), J3.39 (~IRQ_2), J4.39 (~IRQ_2), J5.39 (~IRQ_2), J6.39 (~IRQ_2)
/~IRQ_3: J1.41 (~IRQ_3), J2.41 (~IRQ_3), J3.41 (~IRQ_3), J4.41 (~IRQ_3), J5.41 (~IRQ_3), J6.41 (~IRQ_3)
/~IRQ_4: J1.43 (~IRQ_4), J2.43 (~IRQ_4), J3.43 (~IRQ_4), J4.43 (~IRQ_4), J5.43 (~IRQ_4), J6.43 (~IRQ_4)
/~IRQ_5: J1.45 (~IRQ_5), J2.45 (~IRQ_5), J3.45 (~IRQ_5), J4.45 (~IRQ_5), J5.45 (~IRQ_5), J6.45 (~IRQ_5)
/~IRQ_6: J1.47 (~IRQ_6), J2.47 (~IRQ_6), J3.47 (~IRQ_6), J4.47 (~IRQ_6), J5.47 (~IRQ_6), J6.47 (~IRQ_6)
/~IRQ_7: J1.49 (~IRQ_7), J2.49 (~IRQ_7), J3.49 (~IRQ_7), J4.49 (~IRQ_7), J5.49 (~IRQ_7), J6.49 (~IRQ_7)
/~IRQ: J1.12 (~IRQ), J2.12 (~IRQ), J3.12 (~IRQ), J4.12 (~IRQ), J5.12 (~IRQ), J6.12 (~IRQ)
/~ML: J1.16 (~ML), J2.16 (~ML), J3.16 (~ML), J4.16 (~ML), J5.16 (~ML), J6.16 (~ML)
/~NMI: J1.18 (~NMI), J2.18 (~NMI), J3.18 (~NMI), J4.18 (~NMI), J5.18 (~NMI), J6.18 (~NMI)
/~RES: J1.6 (~RES), J2.6 (~RES), J3.6 (~RES), J4.6 (~RES), J5.6 (~RES), J6.6 (~RES)
/~VP: J1.8 (~VP), J2.8 (~VP), J3.8 (~VP), J4.8 (~VP), J5.8 (~VP), J6.8 (~VP)
GND: C1.2, C2.2, J1.1 (GND), J2.1 (GND), J3.1 (GND), J4.1 (GND), J5.1 (GND), J6.1 (GND), J8.2, U1.2 (GND)
VCC: C2.1, J1.2 (VCC), J2.2 (VCC), J3.2 (VCC), J4.2 (VCC), J5.2 (VCC), J6.2 (VCC), U1.3 (VO)

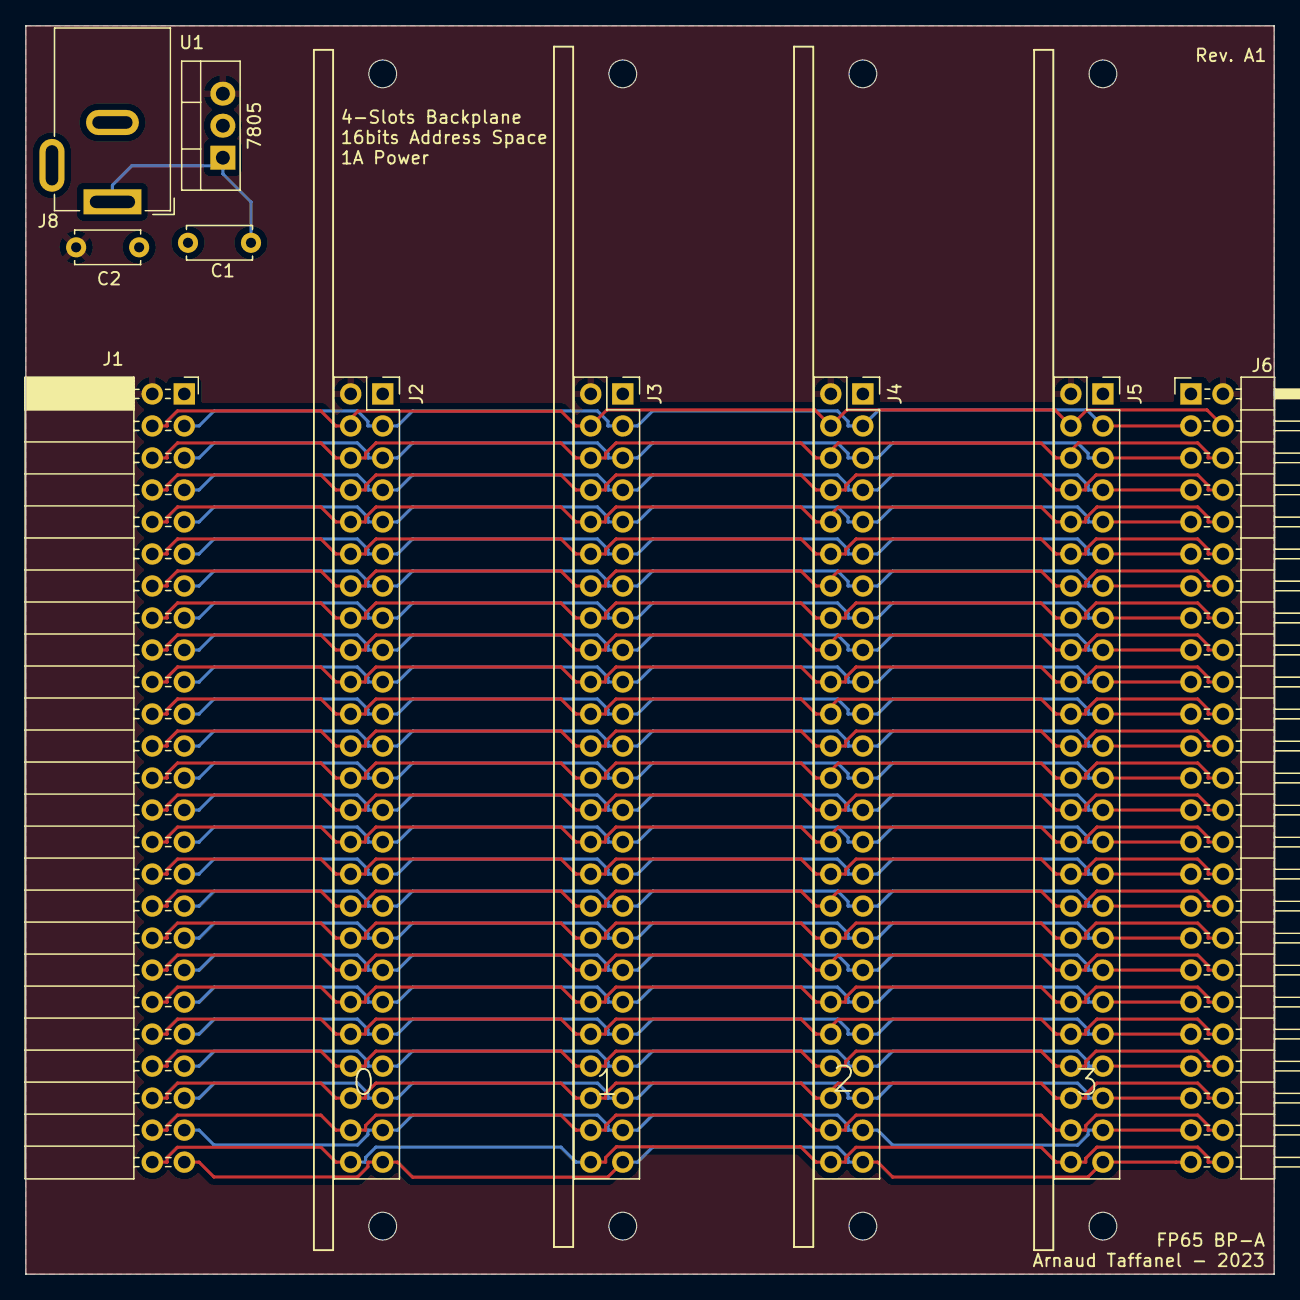
[picture p10: board backplane.kicad_pcb from above]

Board: 2 copper layers, 99.1 x 99.1 mm, 10 parts (0 on the bottom side), 51 nets.
