ataffanel/fp65/ram-a/ram-a.kicad_pcb

## KiCad design ram-a/ram-a.kicad_pcb (2023-10-23)

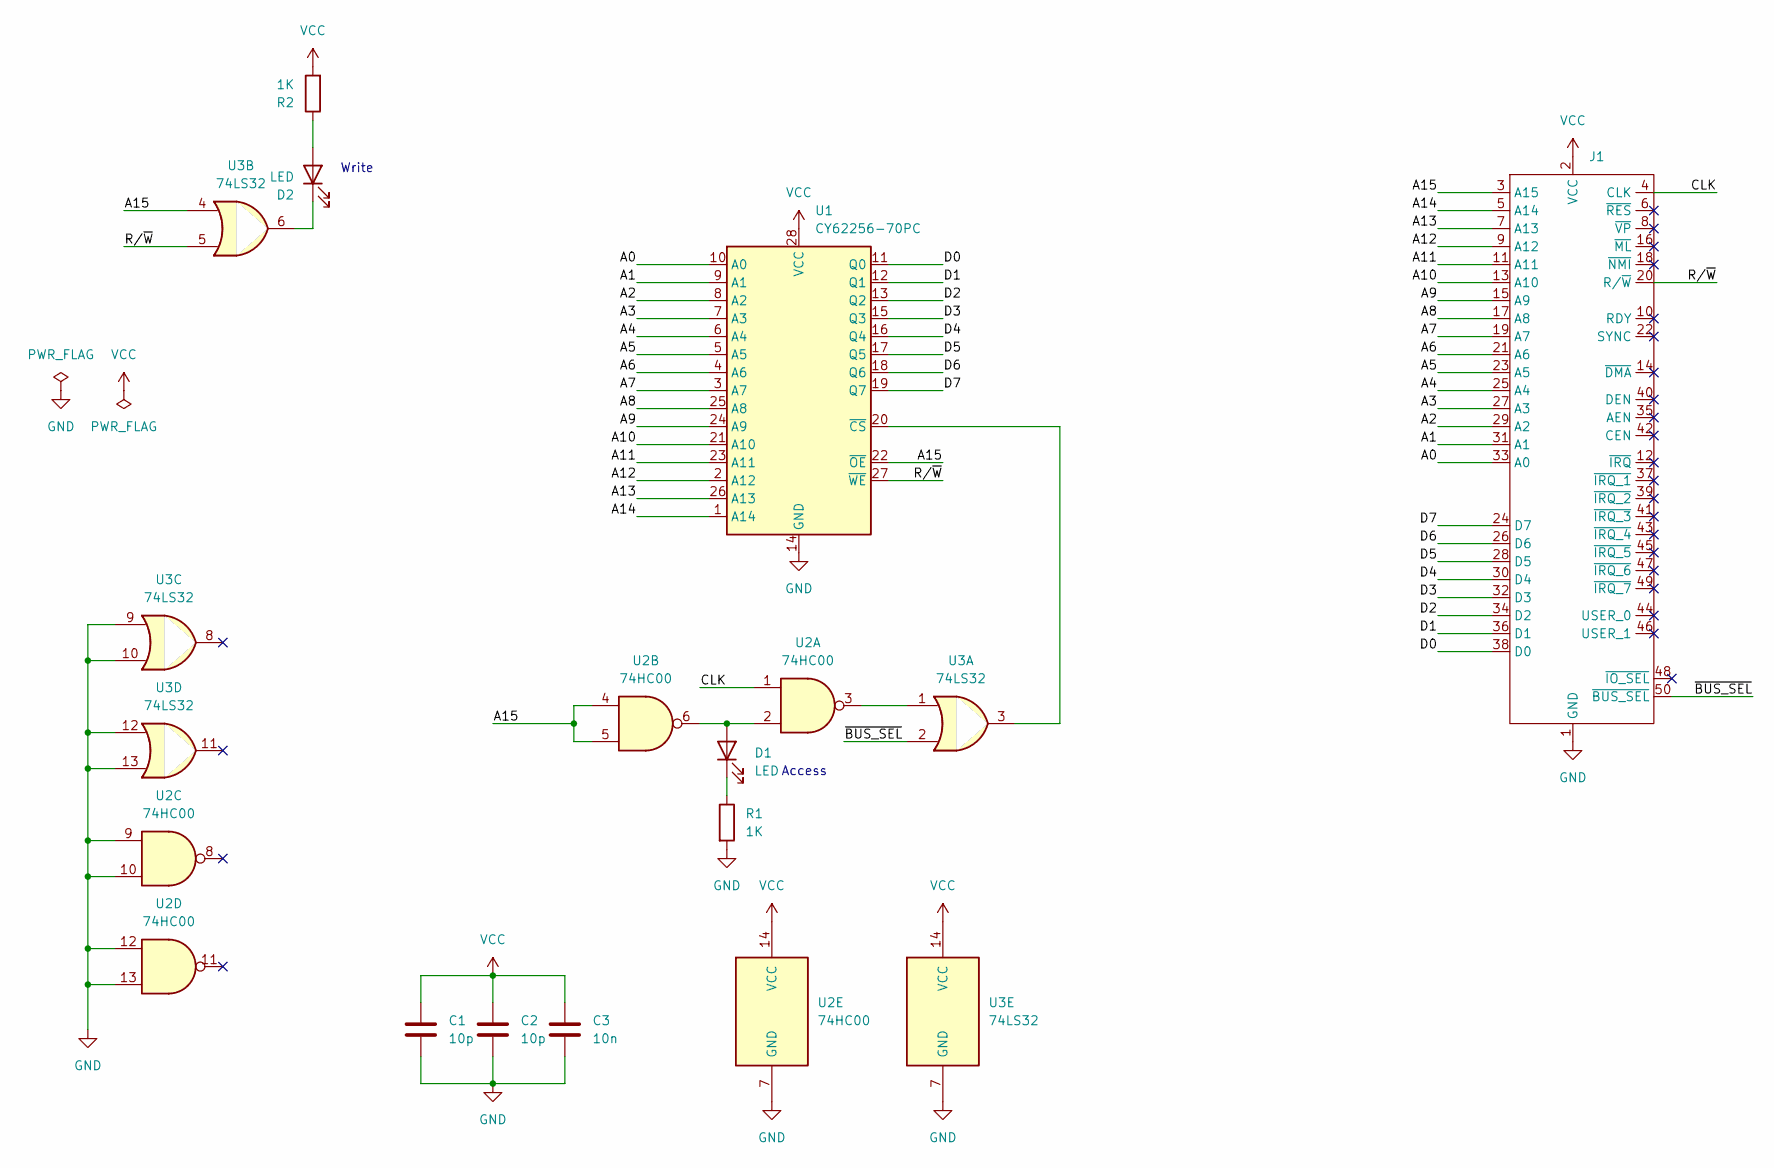
[picture p11: schematic ram-a.kicad_sch]

Parts:
C1, C2: 10p; C_Disc_D4.3mm_W1.9mm_P5.00mm
C3: 10n; C_Disc_D4.3mm_W1.9mm_P5.00mm
D1, D2: LED; LED_D3.0mm_Horizontal_O1.27mm_Z2.0mm
J1: PinHeader_2x25_P2.54mm_Horizontal
R1, R2: 1K; R_Axial_DIN0204_L3.6mm_D1.6mm_P7.62mm_Horizontal
U1: CY62256-70PC; DIP-28_W15.24mm
U2: 74HC00; DIP-14_W7.62mm
U3: 74LS32; DIP-14_W7.62mm

Connections:
/A0: J1.33 (A0), U1.10 (A0)
/A1: J1.31 (A1), U1.9 (A1)
/A2: J1.29 (A2), U1.8 (A2)
/A3: J1.27 (A3), U1.7 (A3)
/A4: J1.25 (A4), U1.6 (A4)
/A5: J1.23 (A5), U1.5 (A5)
/A6: J1.21 (A6), U1.4 (A6)
/A7: J1.19 (A7), U1.3 (A7)
/A8: J1.17 (A8), U1.25 (A8)
/A9: J1.15 (A9), U1.24 (A9)
/A10: J1.13 (A10), U1.21 (A10)
/A11: J1.11 (A11), U1.23 (A11)
/A12: J1.9 (A12), U1.2 (A12)
/A13: J1.7 (A13), U1.26 (A13)
/A14: J1.5 (A14), U1.1 (A14)
/A15: J1.3 (A15), U1.22 (~OE), U2.4, U2.5, U3.4
/CLK: J1.4 (CLK), U2.1
/D0: J1.38 (D0), U1.11 (Q0)
/D1: J1.36 (D1), U1.12 (Q1)
/D2: J1.34 (D2), U1.13 (Q2)
/D3: J1.32 (D3), U1.15 (Q3)
/D4: J1.30 (D4), U1.16 (Q4)
/D5: J1.28 (D5), U1.17 (Q5)
/D6: J1.26 (D6), U1.18 (Q6)
/D7: J1.24 (D7), U1.19 (Q7)
/R/~W: J1.20 (R/~W), U1.27 (~WE), U3.5
/~BUS_SEL: J1.50 (~BUS_SEL), U3.2
GND: C1.2, C2.2, C3.2, J1.1 (GND), R1.2, U1.14 (GND), U2.7 (GND), U2.9, U2.10, U2.12, U2.13, U3.7 (GND), U3.9, U3.10, U3.12, U3.13
unnamed: D1.2 (A), U2.2, U2.6
unnamed: D1.1 (K), R1.1
unnamed: D2.2 (A), R2.1
unnamed: D2.1 (K), U3.6
unnamed: U1.20 (~CS), U3.3
unnamed: U2.3, U3.1
VCC: C1.1, C2.1, C3.1, J1.2 (VCC), R2.2, U1.28 (VCC), U2.14 (VCC), U3.14 (VCC)

Notes on the sheet:
Access
Write

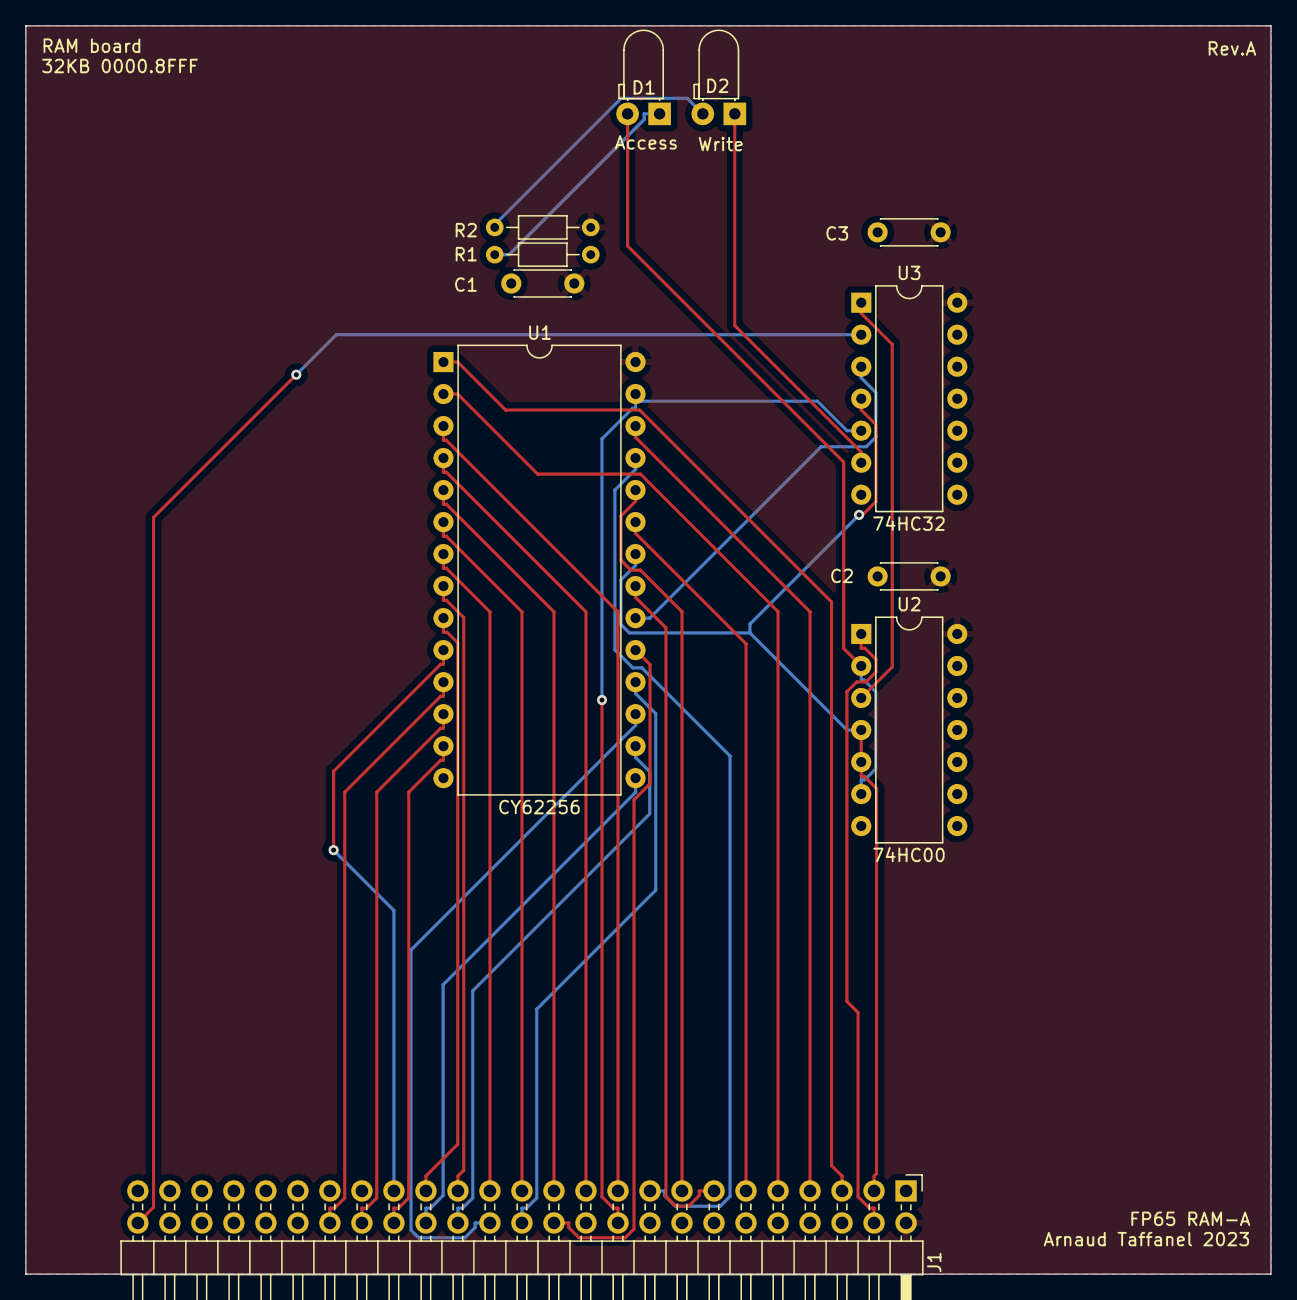
[picture p12: board ram-a.kicad_pcb from above]

Board: 2 copper layers, 98.8 x 99.1 mm, 11 parts (0 on the bottom side), 35 nets.
