ataffanel/fp65/rom-a/rom-a.kicad_pcb

## KiCad design rom-a/rom-a.kicad_pcb (2023-10-23)

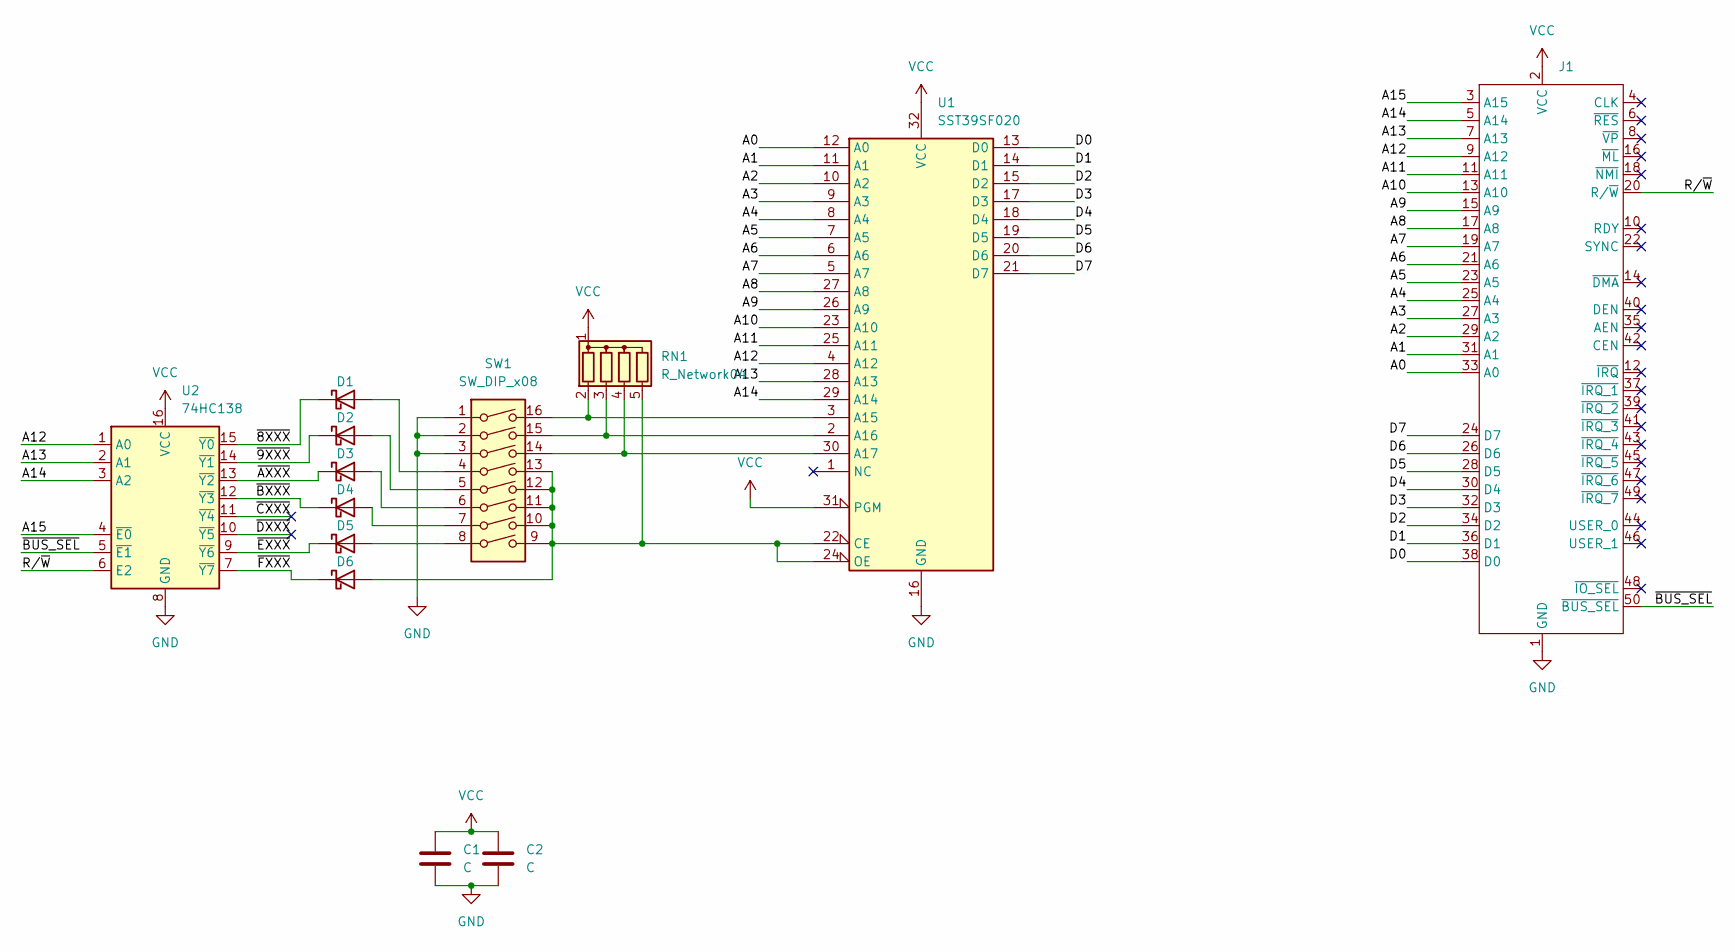
[picture p13: schematic rom-a.kicad_sch]

Parts:
C1, C2: C; C_Disc_D3.4mm_W2.1mm_P2.50mm
D1, D2, D3, D4, D5, D6: D_Schottky; D_DO-35_SOD27_P7.62mm_Horizontal
J1: PinHeader_2x25_P2.54mm_Horizontal
RN1: R_Network04; R_Array_SIP5
SW1: SW_DIP_x08; SW_DIP_SPSTx08_Slide_9.78x22.5mm_W7.62mm_P2.54mm
U1: SST39SF020; DIP-32_W15.24mm
U2: 74HC138; DIP-16_W7.62mm

Connections:
/A0: J1.33 (A0), U1.12 (A0)
/A1: J1.31 (A1), U1.11 (A1)
/A2: J1.29 (A2), U1.10 (A2)
/A3: J1.27 (A3), U1.9 (A3)
/A4: J1.25 (A4), U1.8 (A4)
/A5: J1.23 (A5), U1.7 (A5)
/A6: J1.21 (A6), U1.6 (A6)
/A7: J1.19 (A7), U1.5 (A7)
/A8: J1.17 (A8), U1.27 (A8)
/A9: J1.15 (A9), U1.26 (A9)
/A10: J1.13 (A10), U1.23 (A10)
/A11: J1.11 (A11), U1.25 (A11)
/A12: J1.9 (A12), U1.4 (A12), U2.1 (A0)
/A13: J1.7 (A13), U1.28 (A13), U2.2 (A1)
/A14: J1.5 (A14), U1.29 (A14), U2.3 (A2)
/A15: J1.3 (A15), U2.4 (~E0)
/D0: J1.38 (D0), U1.13 (D0)
/D1: J1.36 (D1), U1.14 (D1)
/D2: J1.34 (D2), U1.15 (D2)
/D3: J1.32 (D3), U1.17 (D3)
/D4: J1.30 (D4), U1.18 (D4)
/D5: J1.28 (D5), U1.19 (D5)
/D6: J1.26 (D6), U1.20 (D6)
/D7: J1.24 (D7), U1.21 (D7)
/R/~W: J1.20 (R/~W), U2.6 (E2)
/~8XXX: D1.1 (K), U2.15 (~Y0)
/~9XXX: D2.1 (K), U2.14 (~Y1)
/~AXXX: D3.1 (K), U2.13 (~Y2)
/~BUS_SEL: J1.50 (~BUS_SEL), U2.5 (~E1)
/~BXXX: D4.1 (K), U2.12 (~Y3)
/~CXXX: U2.11 (~Y4)
/~DXXX: U2.10 (~Y5)
/~EXXX: D5.1 (K), U2.9 (~Y6)
/~FXXX: D6.1 (K), U2.7 (~Y7)
GND: C1.2, C2.2, J1.1 (GND), SW1.1, SW1.2, SW1.3, U1.16 (GND), U2.8 (GND)
unnamed: D1.2 (A), SW1.4
unnamed: D2.2 (A), SW1.5
unnamed: D3.2 (A), SW1.6
unnamed: D4.2 (A), SW1.7
unnamed: D5.2 (A), SW1.8
unnamed: D6.2 (A), RN1.5 (R4), SW1.9, SW1.10, SW1.11, SW1.12, SW1.13, U1.22 (CE), U1.24 (OE)
unnamed: RN1.2 (R1), SW1.16, U1.3 (A15)
unnamed: RN1.3 (R2), SW1.15, U1.2 (A16)
unnamed: RN1.4 (R3), SW1.14, U1.30 (A17)
VCC: C1.1, C2.1, J1.2 (VCC), RN1.1 (common), U1.31 (PGM), U1.32 (VCC), U2.16 (VCC)

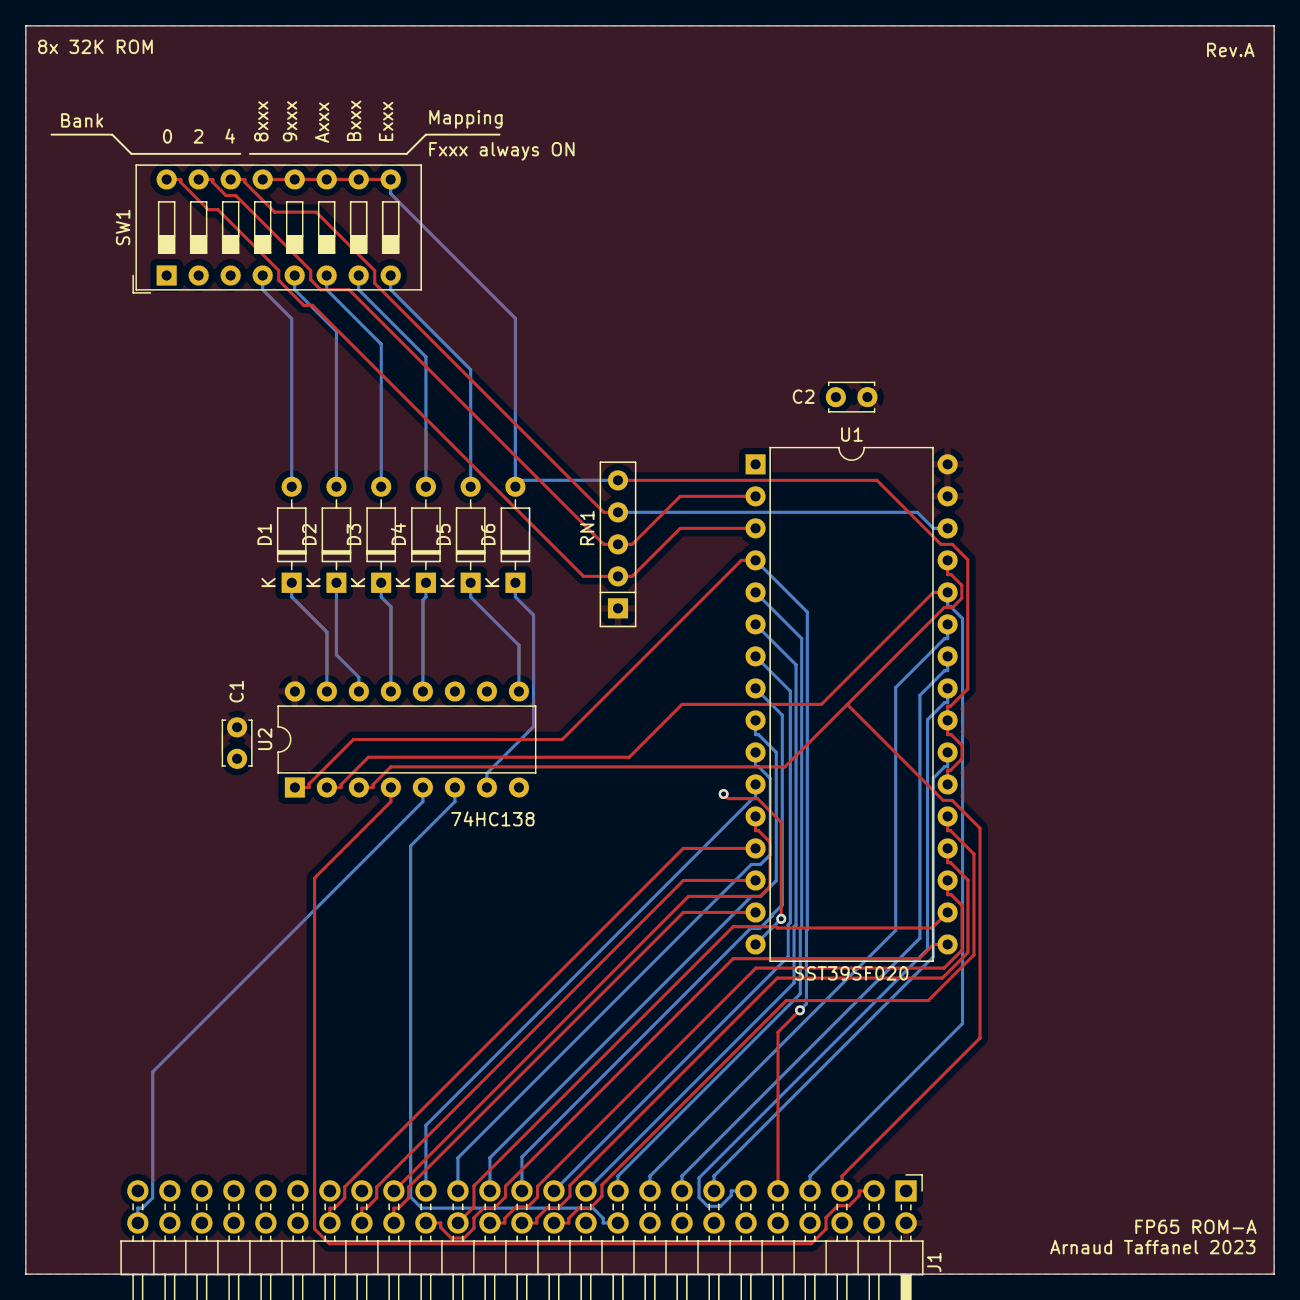
[picture p14: board rom-a.kicad_pcb from above]

Board: 2 copper layers, 99.1 x 99.1 mm, 13 parts (0 on the bottom side), 43 nets.
