ataffanel/fp65/usbio-a/usbio-a.kicad_pcb

## KiCad design usbio-a/usbio-a.kicad_pcb (2023-10-23)

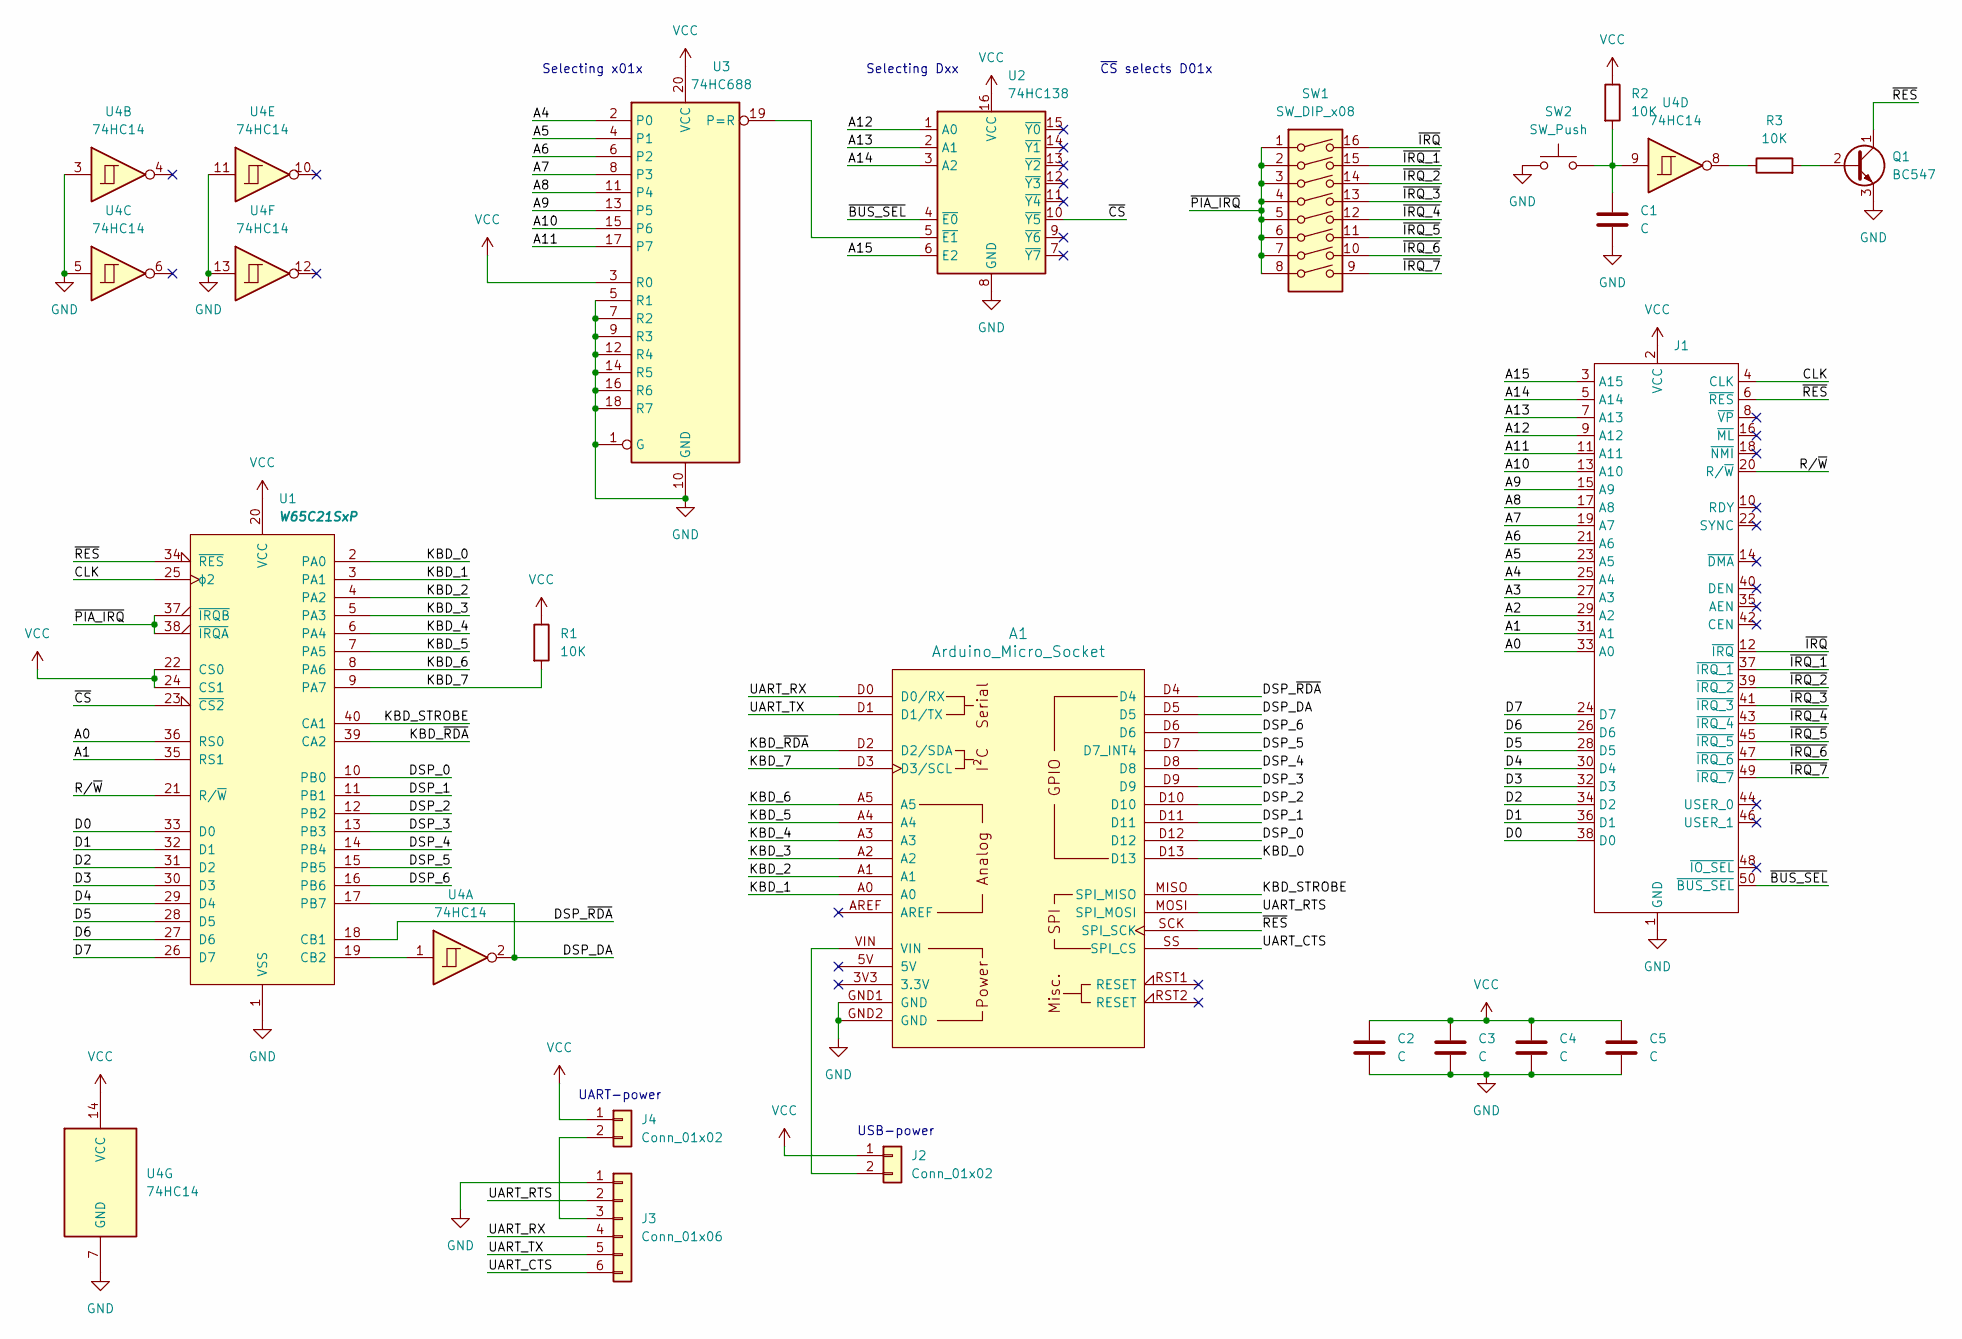
[picture p15: schematic usbio-a.kicad_sch]

Parts:
A1: Arduino_Micro_Socket
C1, C2, C3, C4, C5: C; C_Disc_D4.7mm_W2.5mm_P5.00mm
J1: PinHeader_2x25_P2.54mm_Horizontal
J2, J4: Conn_01x02; PinHeader_1x02_P2.54mm_Vertical
J3: Conn_01x06; PinHeader_1x06_P2.54mm_Horizontal
Q1: BC547; TO-92_Inline
R1, R2, R3: 10K; R_Axial_DIN0207_L6.3mm_D2.5mm_P15.24mm_Horizontal
SW1: SW_DIP_x08; SW_DIP_SPSTx08_Slide_9.78x22.5mm_W7.62mm_P2.54mm
SW2: SW_Push; SW_PUSH_6mm
U1: W65C21SxP; DIP-40_W15.24mm
U2: 74HC138; DIP-16_W7.62mm
U3: 74HC688; DIP-20_W7.62mm
U4: 74HC14; DIP-14_W7.62mm

Connections:
/A0: J1.33 (A0), U1.36 (RS0)
/A1: J1.31 (A1), U1.35 (RS1)
/A2: J1.29 (A2)
/A3: J1.27 (A3)
/A4: J1.25 (A4), U3.2 (P0)
/A5: J1.23 (A5), U3.4 (P1)
/A6: J1.21 (A6), U3.6 (P2)
/A7: J1.19 (A7), U3.8 (P3)
/A8: J1.17 (A8), U3.11 (P4)
/A9: J1.15 (A9), U3.13 (P5)
/A10: J1.13 (A10), U3.15 (P6)
/A11: J1.11 (A11), U3.17 (P7)
/A12: J1.9 (A12), U2.1 (A0)
/A13: J1.7 (A13), U2.2 (A1)
/A14: J1.5 (A14), U2.3 (A2)
/A15: J1.3 (A15), U2.6 (E2)
/CLK: J1.4 (CLK), U1.25 (ϕ2)
/D0: J1.38 (D0), U1.33 (D0)
/D1: J1.36 (D1), U1.32 (D1)
/D2: J1.34 (D2), U1.31 (D2)
/D3: J1.32 (D3), U1.30 (D3)
/D4: J1.30 (D4), U1.29 (D4)
/D5: J1.28 (D5), U1.28 (D5)
/D6: J1.26 (D6), U1.27 (D6)
/D7: J1.24 (D7), U1.26 (D7)
/DSP_0: A1.D12, U1.10 (PB0)
/DSP_1: A1.D11, U1.11 (PB1)
/DSP_2: A1.D10, U1.12 (PB2)
/DSP_3: A1.D9, U1.13 (PB3)
/DSP_4: A1.D8, U1.14 (PB4)
/DSP_5: A1.D7 (D7_INT4), U1.15 (PB5)
/DSP_6: A1.D6, U1.16 (PB6)
/DSP_DA: A1.D5, U1.17 (PB7), U4.2
/DSP_~RDA: A1.D4, U1.18 (CB1)
/KBD_0: A1.D13, U1.2 (PA0)
/KBD_1: A1.A0, U1.3 (PA1)
/KBD_2: A1.A1, U1.4 (PA2)
/KBD_3: A1.A2, U1.5 (PA3)
/KBD_4: A1.A3, U1.6 (PA4)
/KBD_5: A1.A4, U1.7 (PA5)
/KBD_6: A1.A5, U1.8 (PA6)
/KBD_7: A1.D3 (D3/SCL), R1.2, U1.9 (PA7)
/KBD_STROBE: A1.MISO (SPI_MISO), U1.40 (CA1)
/KBD_~RDA: A1.D2 (D2/SDA), U1.39 (CA2)
/R/~W: J1.20 (R/~W), U1.21 (R/~W)
/UART_CTS: A1.SS (SPI_CS), J3.6
/UART_RTS: A1.MOSI (SPI_MOSI), J3.2
/UART_RX: A1.D0 (D0/RX), J3.4
/UART_TX: A1.D1 (D1/TX), J3.5
/~BUS_SEL: J1.50 (~BUS_SEL), U2.4 (~E0)
/~CS: U1.23 (~CS2), U2.10 (~Y5)
/~IRQ_1: J1.37 (~IRQ_1), SW1.15
/~IRQ_2: J1.39 (~IRQ_2), SW1.14
/~IRQ_3: J1.41 (~IRQ_3), SW1.13
/~IRQ_4: J1.43 (~IRQ_4), SW1.12
/~IRQ_5: J1.45 (~IRQ_5), SW1.11
/~IRQ_6: J1.47 (~IRQ_6), SW1.10
/~IRQ_7: J1.49 (~IRQ_7), SW1.9
/~IRQ: J1.12 (~IRQ), SW1.16
/~PIA_IRQ: SW1.1, SW1.2, SW1.3, SW1.4, SW1.5, SW1.6, SW1.7, SW1.8, U1.37 (~IRQB), U1.38 (~IRQA)
/~RES: A1.SCK (SPI_SCK), J1.6 (~RES), Q1.1 (C), U1.34 (~RES)
GND: A1.GND1 (GND), A1.GND2 (GND), C1.2, C2.2, C3.2, C4.2, C5.2, J1.1 (GND), J3.1, Q1.3 (E), SW2.1, U1.1 (VSS), U2.8 (GND), U3.1 (G), U3.5 (R1), U3.7 (R2), U3.9 (R3), U3.10 (GND), U3.12 (R4), U3.14 (R5), U3.16 (R6), U3.18 (R7), U4.3, U4.5, U4.7 (GND), U4.11, U4.13
unnamed: C1.1, R2.2, SW2.2, U4.9
unnamed: A1.VIN, J2.2
unnamed: J3.3, J4.2
unnamed: Q1.2 (B), R3.2
unnamed: R3.1, U4.8
unnamed: U1.19 (CB2), U4.1
unnamed: U2.5 (~E1), U3.19 (P=R)
VCC: C2.1, C3.1, C4.1, C5.1, J1.2 (VCC), J2.1, J4.1, R1.1, R2.1, U1.20 (VCC), U1.22 (CS0), U1.24 (CS1), U2.16 (VCC), U3.3 (R0), U3.20 (VCC), U4.14 (VCC)

Notes on the sheet:
UART-power
~{CS} selects D01x
Selecting Dxx
Selecting x01x
USB-power

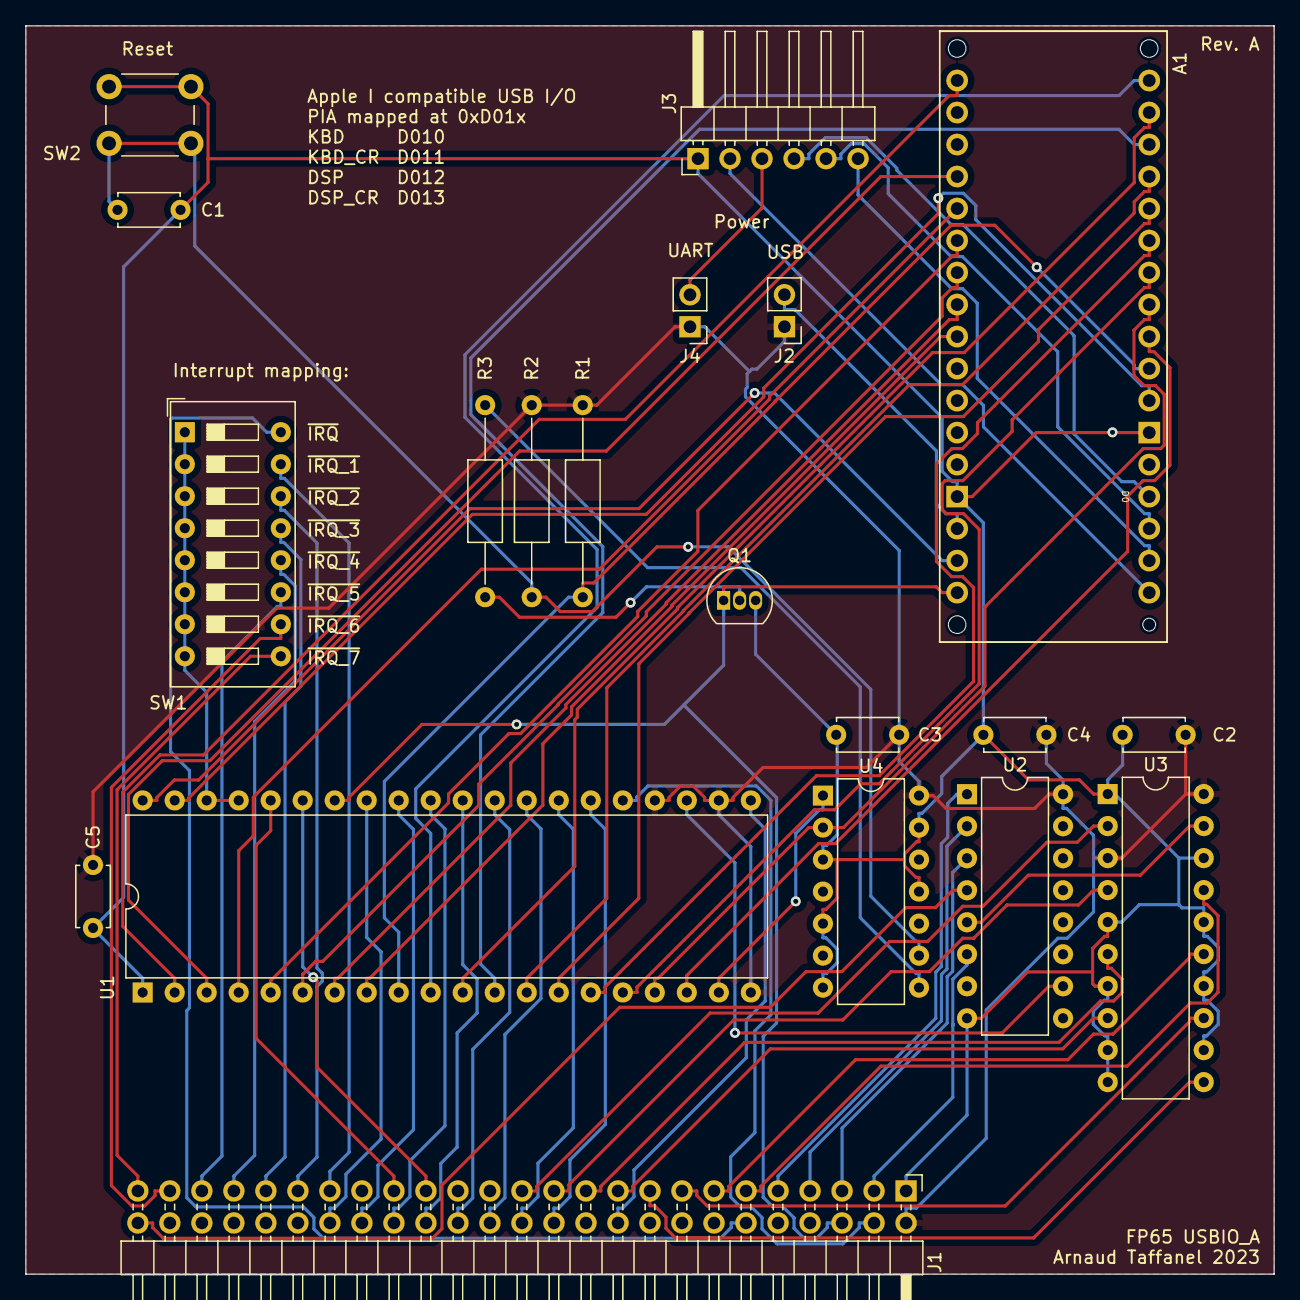
[picture p16: board usbio-a.kicad_pcb from above]

Board: 2 copper layers, 99.1 x 99.1 mm, 20 parts (0 on the bottom side), 68 nets.
