ataffanel/fp65/(commit log)

2023-10-23 Initial ordered board
    [backplane.kicad_pcb, backplane.kicad_sch, cp-a.kicad_pcb, cp-a.kicad_sch, freerouting.dsn, mpu-a.kicad_pcb, mpu-a.kicad_sch, ram-a.kicad_pcb]
2023-12-28 Add mounting/alignement holes to backplane
    [backplane.kicad_pcb]
2023-12-28 Specify resistors values to MPU-A
    [mpu-a.kicad_pcb, mpu-a.kicad_sch]
2023-12-28 Add SCSI-A board: 8 bits SCSI SC interface
    [scsi-a.kicad_pcb, scsi-a.kicad_sch]
2023-12-28 Add SIO-A board: RS232 Serial I/0 and VIA PIO/Timer
    [sio-a.kicad_pcb, sio-a.kicad_sch]
2023-12-28 Minimal change to fix SCSI CPU-Bus connection
    [scsi-a.kicad_pcb, scsi-a.kicad_sch]
2023-12-28 Fix SIO-A CPU bus R/W logic
    [sio-a.kicad_pcb, sio-a.kicad_sch]
2023-12-28 Fix DB footprint on SCSI-A and SIO-A
    [scsi-a.kicad_pcb, scsi-a.kicad_sch, sio-a.kicad_pcb, sio-a.kicad_sch]
